jesodium/Blackout/arduino-mega/ref-images/L293D-Shield-Hardware-Overview.webp

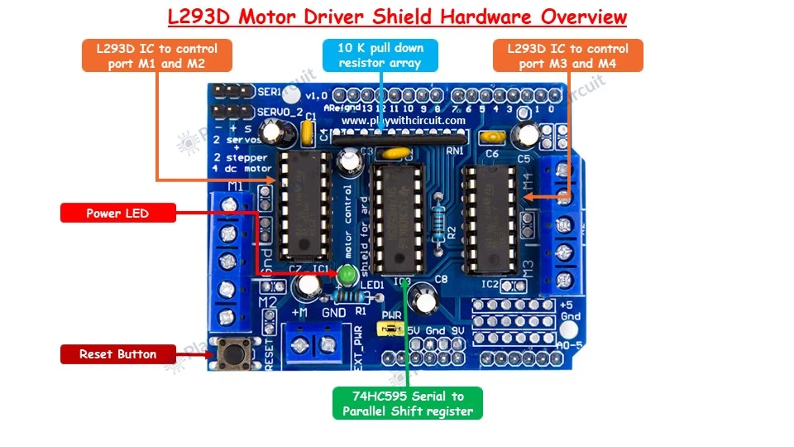
arduino-mega/ref-images/L293D-Shield-Hardware-Overview.webp
