jesodium/Blackout/docs/assets/frame-relic.jpg

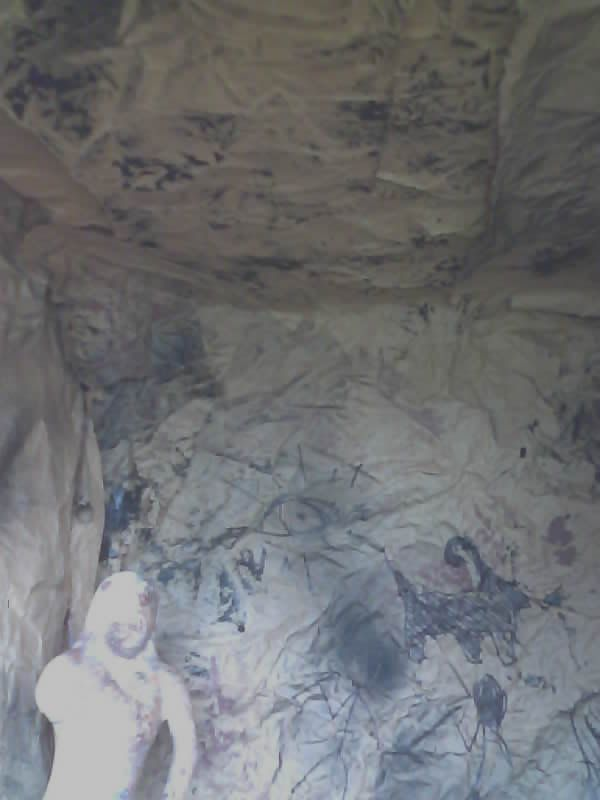
docs/assets/frame-relic.jpg
