jesodium/Blackout/arduino-mega-code/deepseek.md

See [AGENTS.md](AGENTS.md) for project context and wiring instructions.
