jesodium/Blackout/docs/assets/frame-debris.jpg

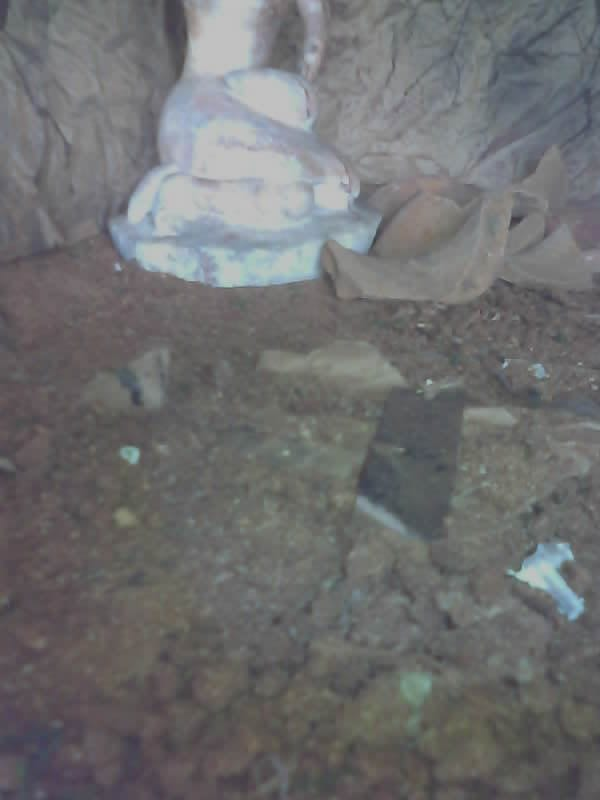
docs/assets/frame-debris.jpg
