jesodium/Blackout/docs/assets/frame-painted.jpg

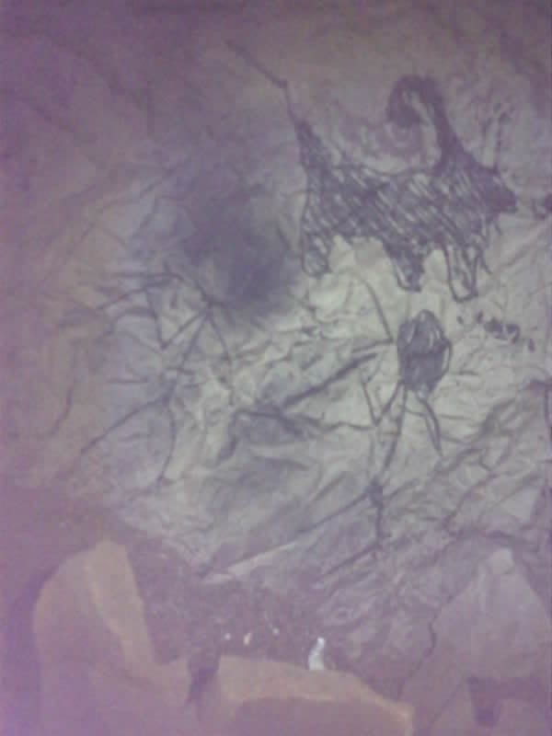
docs/assets/frame-painted.jpg
