jesodium/Blackout/docs/assets/frame-shapes.jpg

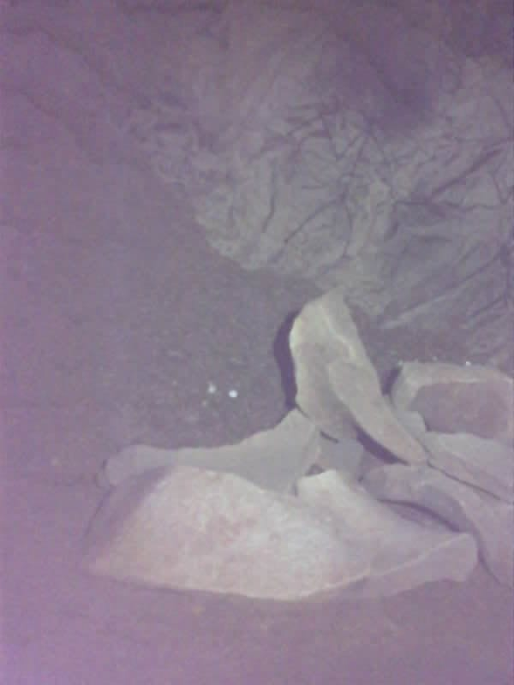
docs/assets/frame-shapes.jpg
