jesodium/Blackout/docs/assets/frame-void.jpg

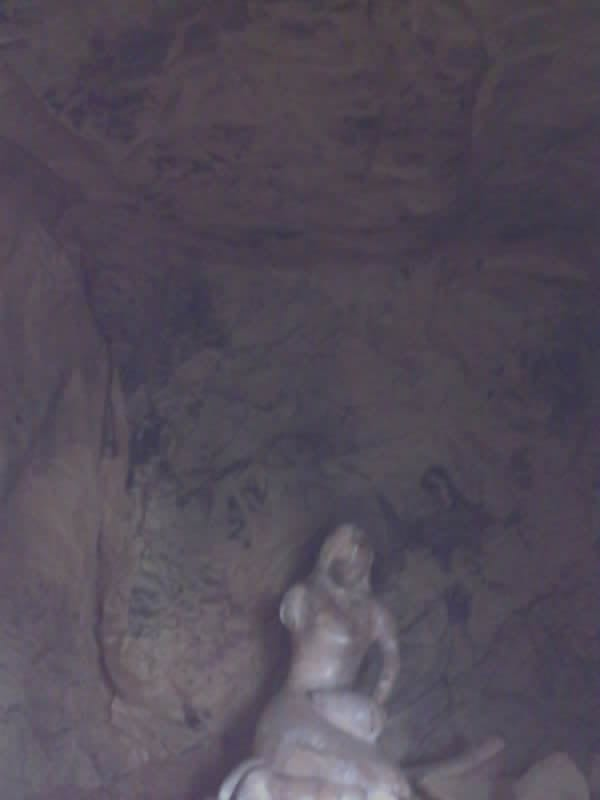
docs/assets/frame-void.jpg
