jesodium/Blackout/docs/assets/frame-water.jpg

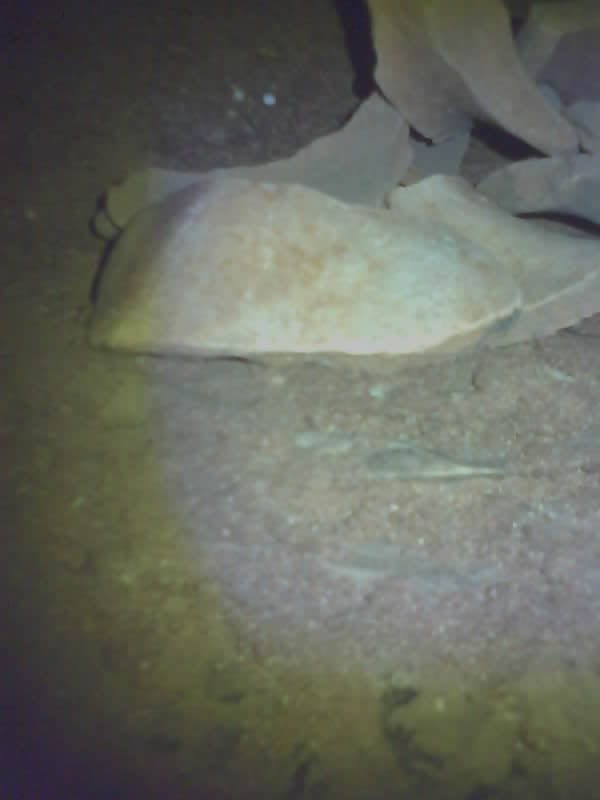
docs/assets/frame-water.jpg
