jesodium/Blackout/docs/assets/rover-cave.jpg

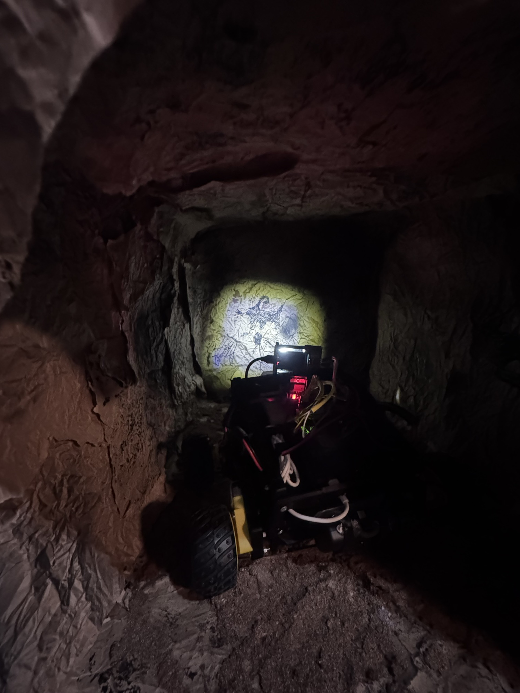
docs/assets/rover-cave.jpg
