jesodium/Blackout/docs/assets/rover.jpg

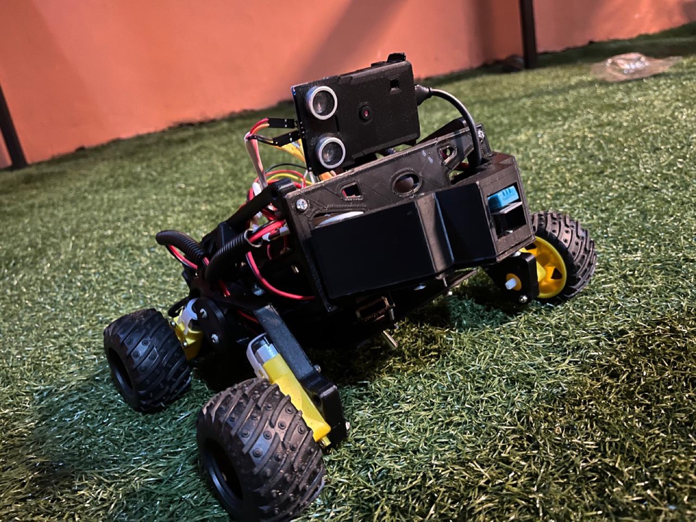
docs/assets/rover.jpg
