jesodium/Blackout/docs/assets/shot-blk-card.jpg

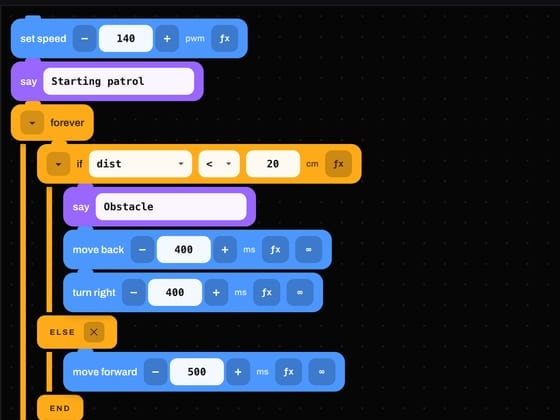
docs/assets/shot-blk-card.jpg
