jesodium/Blackout/docs/assets/shot-blk-sim.jpg

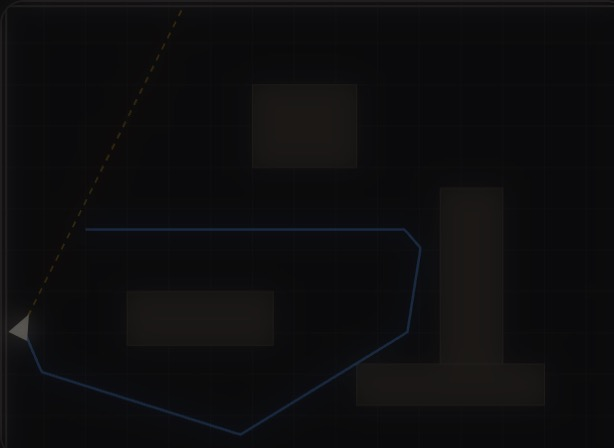
docs/assets/shot-blk-sim.jpg
