jesodium/Blackout/docs/assets/shot-fpv.jpg

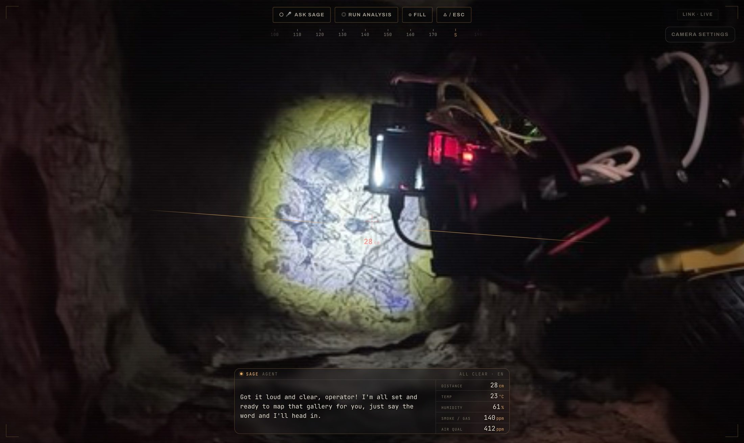
docs/assets/shot-fpv.jpg
