jesodium/Blackout/docs/assets/shot-report-card.jpg

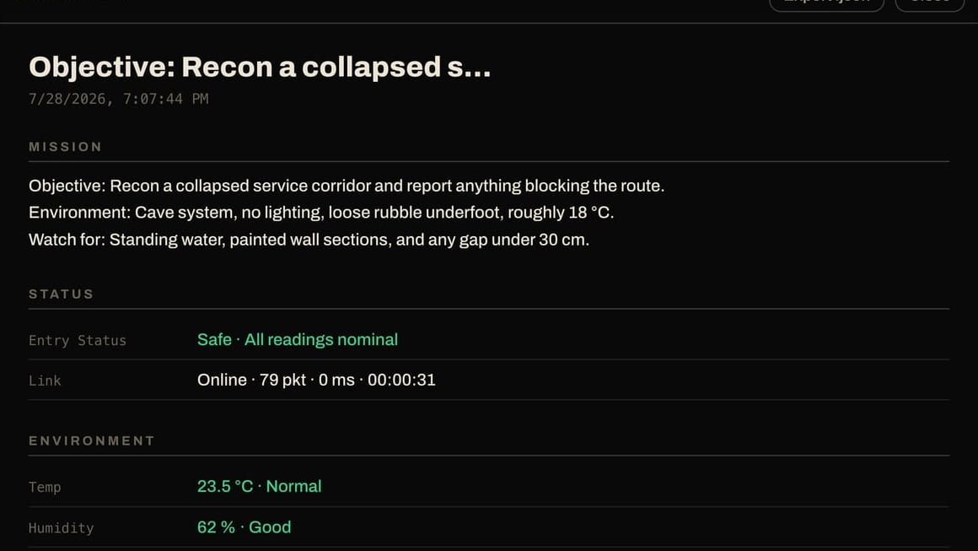
docs/assets/shot-report-card.jpg
