jesodium/Blackout/docs/assets/sponsor-steel-services.jpg

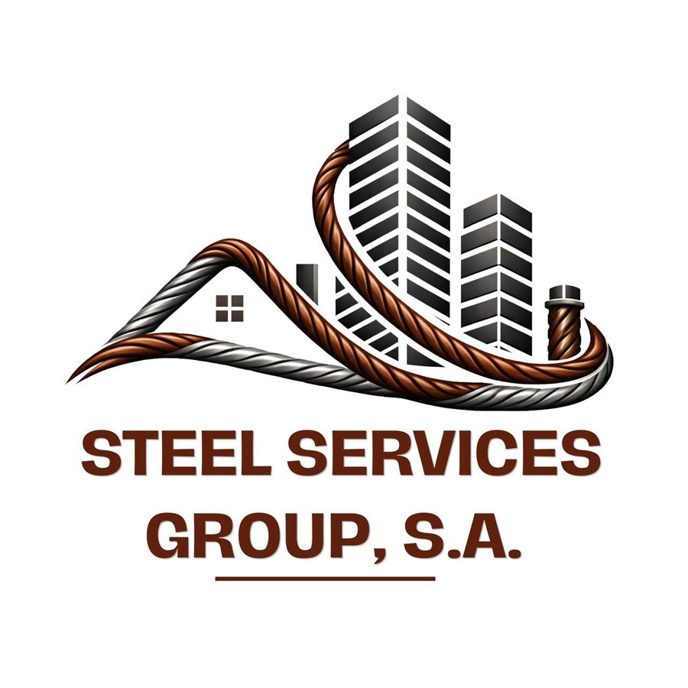
docs/assets/sponsor-steel-services.jpg
