jesodium/Blackout/docs/code-shots/0-repo-structure.png

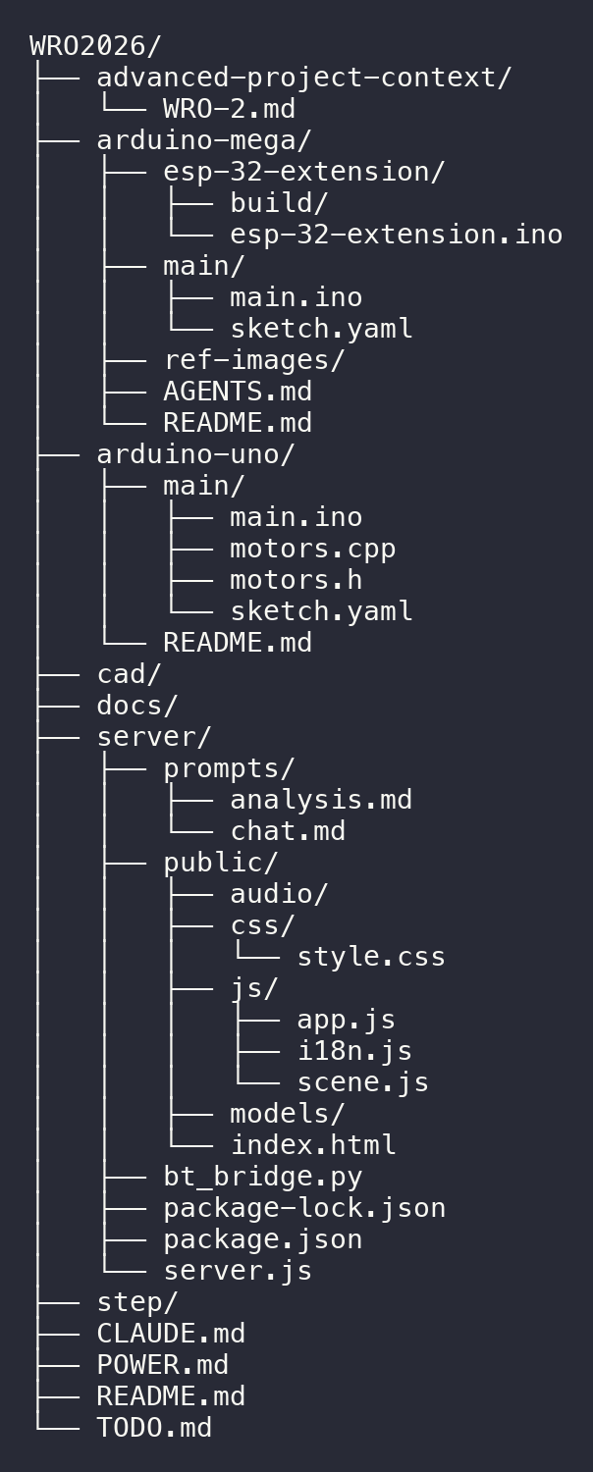
docs/code-shots/0-repo-structure.png
