jesodium/Blackout/docs/code-shots/1-mega-sensors.png

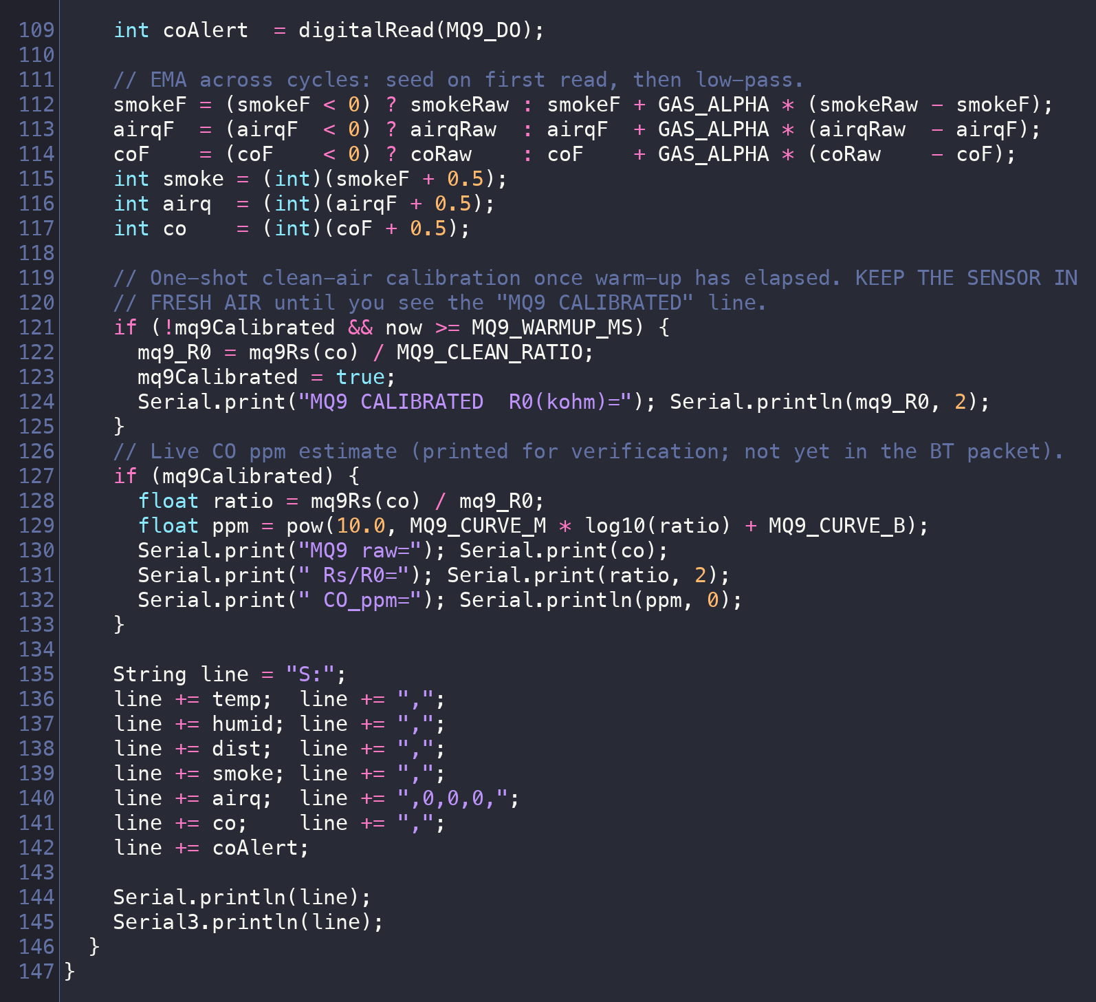
docs/code-shots/1-mega-sensors.png
