jesodium/Blackout/docs/code-shots/2-uno-motors.png

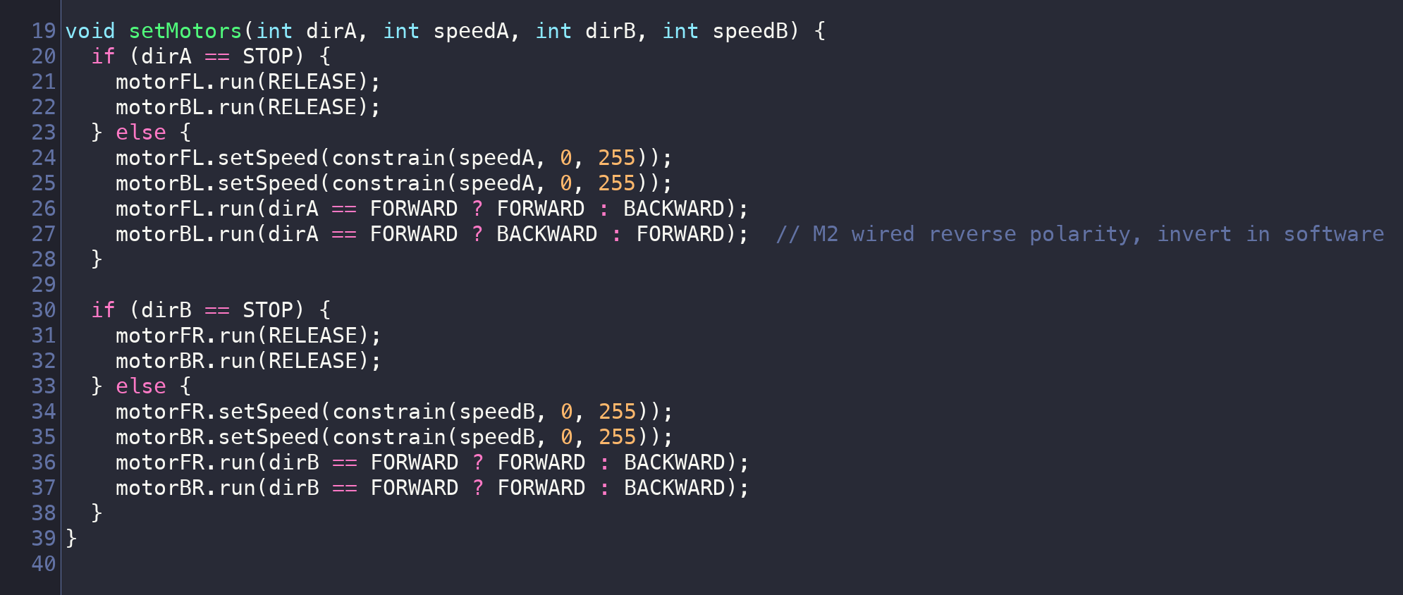
docs/code-shots/2-uno-motors.png
