jesodium/Blackout/docs/code-shots/3-server-telemetry.png

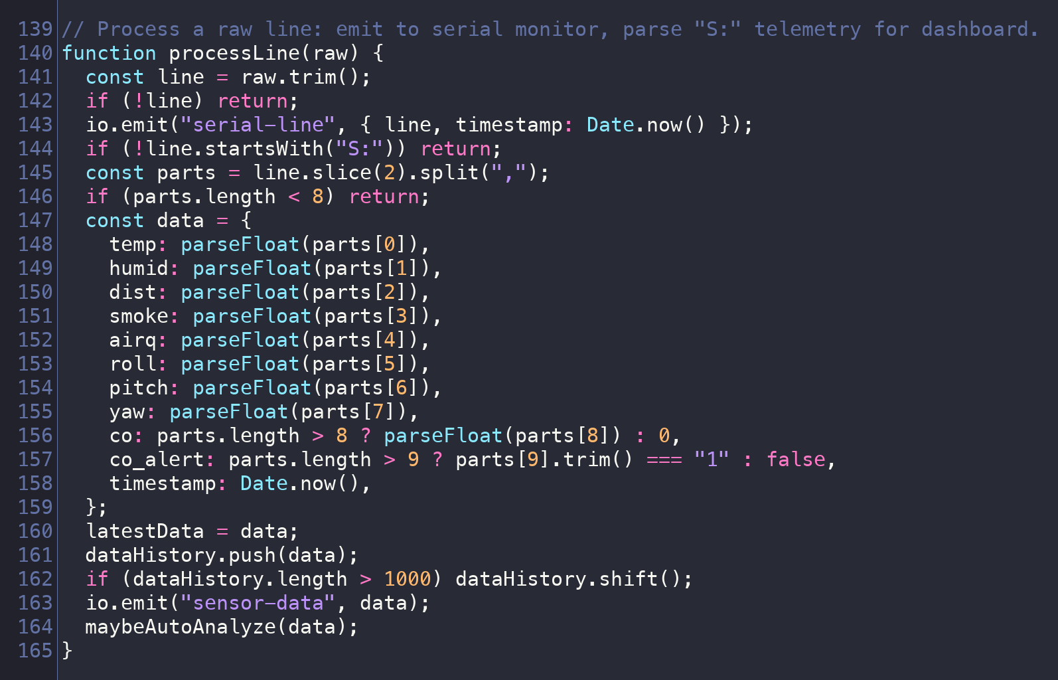
docs/code-shots/3-server-telemetry.png
