jesodium/Blackout/docs/code-shots/4-scene-threejs.png

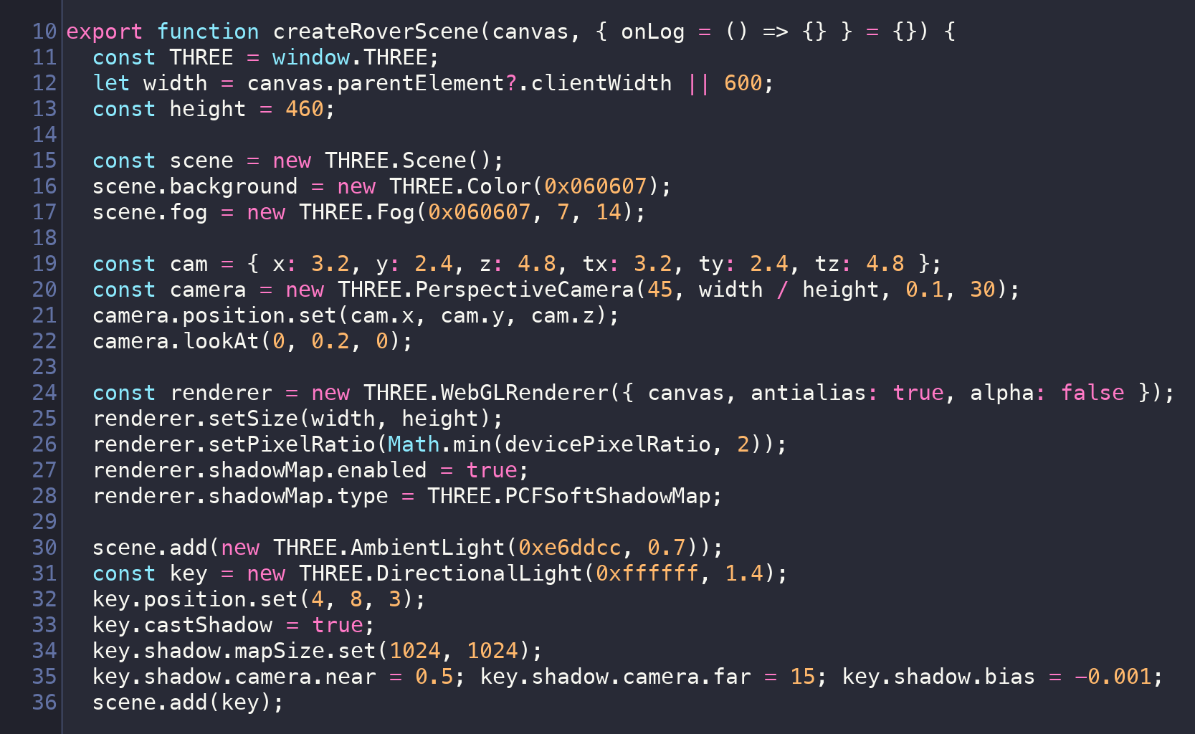
docs/code-shots/4-scene-threejs.png
