jesodium/Blackout/docs/figs/fig1.png

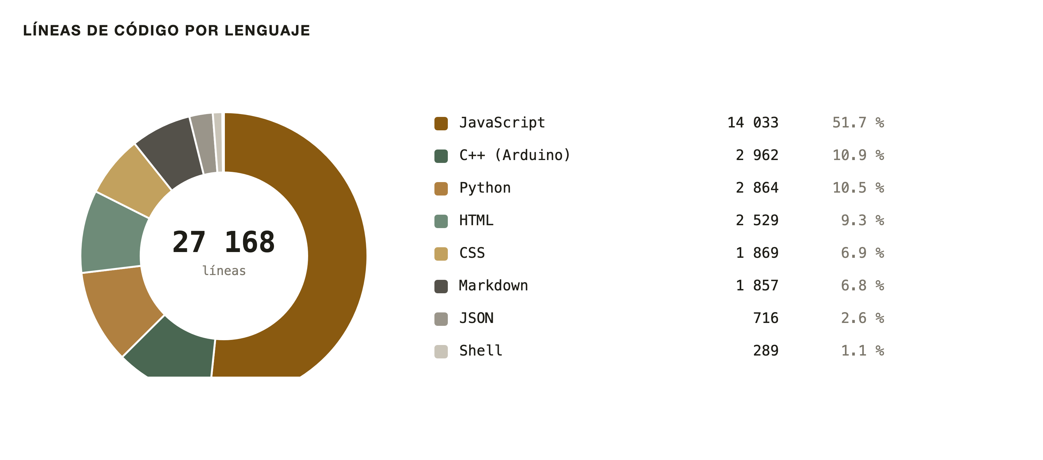
docs/figs/fig1.png
