jesodium/Blackout/docs/figs/fig3.png

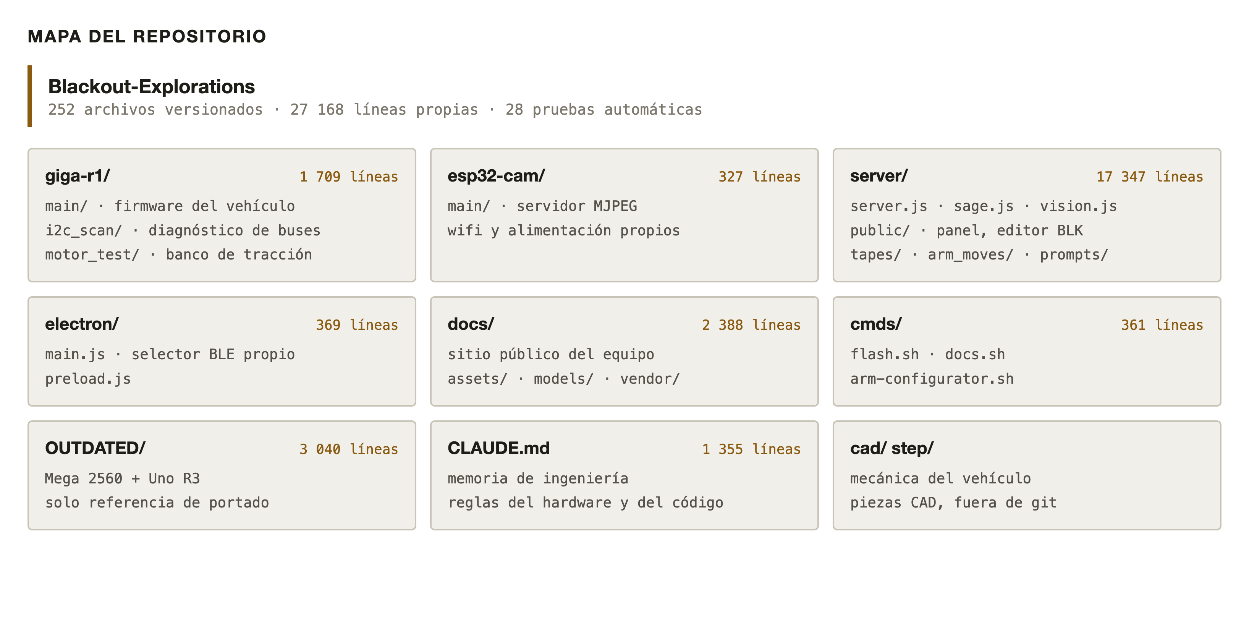
docs/figs/fig3.png
