jesodium/Blackout/stls/main_frame-MK2.STL

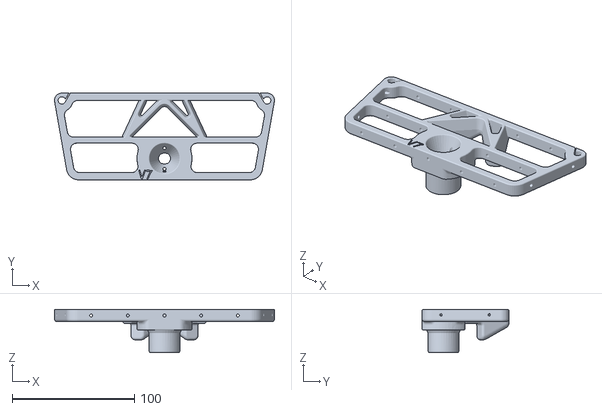
[picture p22: CAD file, 2026-05-28]
stls/main_frame-MK2.STL
180.0 x 71.0 x 35.4
