jesodium/Blackout/stls/rockers-MK2.STL

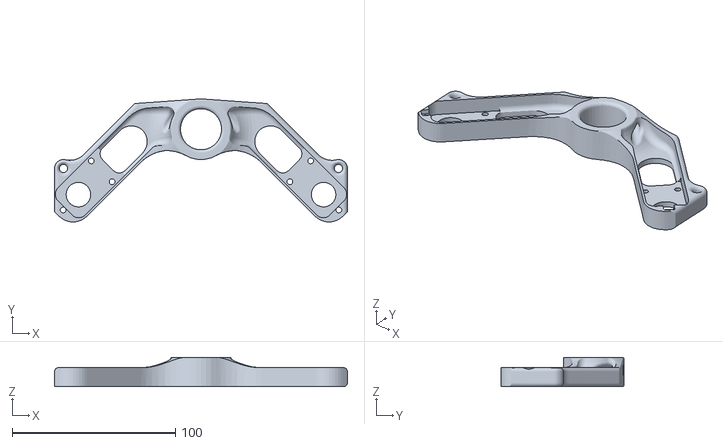
[picture p23: CAD file, 2026-05-28]
stls/rockers-MK2.STL
179.3 x 75.2 x 18.0
