jesodium/Blackout/stls/Brace_frame-MK2.STL

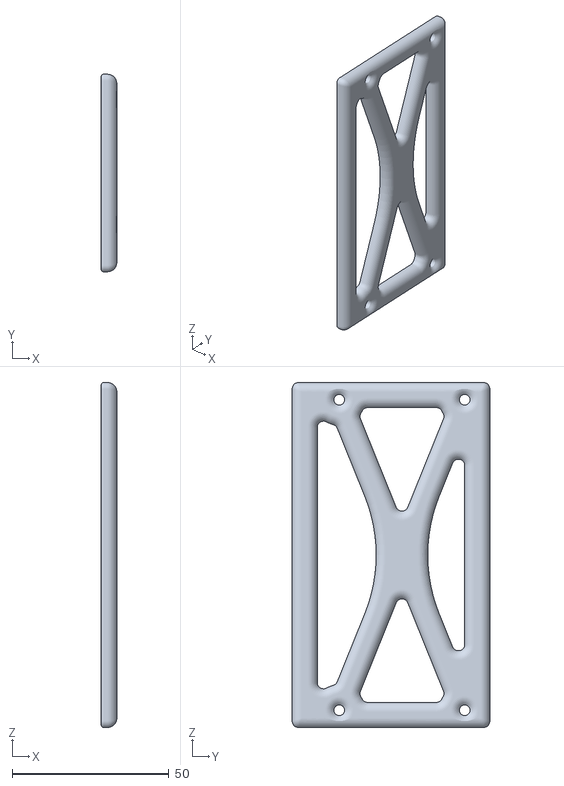
[picture p24: CAD file, 2026-05-28]
stls/Brace_frame-MK2.STL
5.00 x 63.0 x 110.0
