jesodium/Blackout/stls/belly_frame-MK2.STL

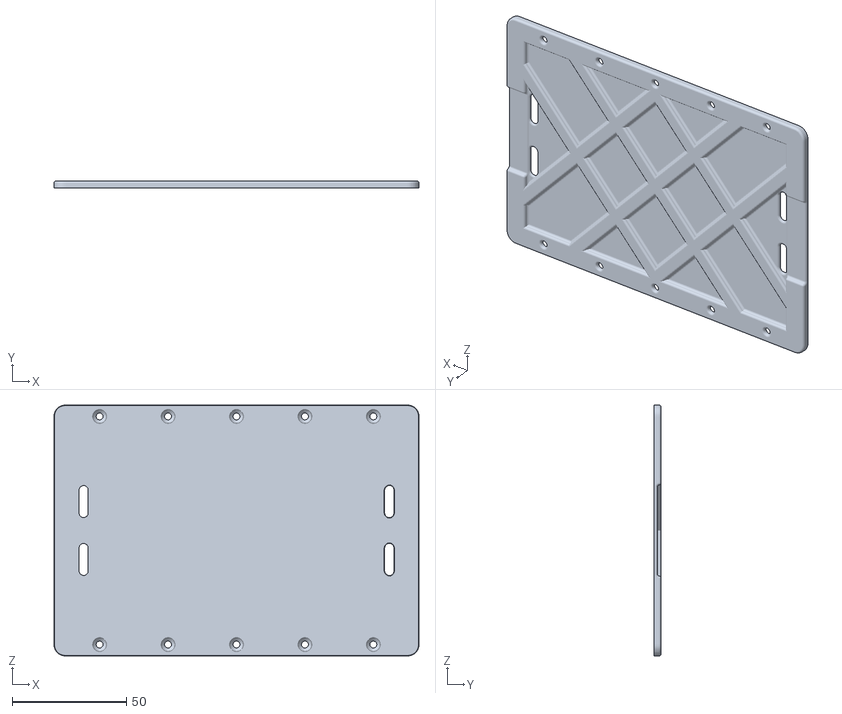
[picture p25: CAD file, 2026-05-28]
stls/belly_frame-MK2.STL
160.0 x 3.20 x 110.0
