jesodium/Blackout/stls/mid_frame-MK2.STL

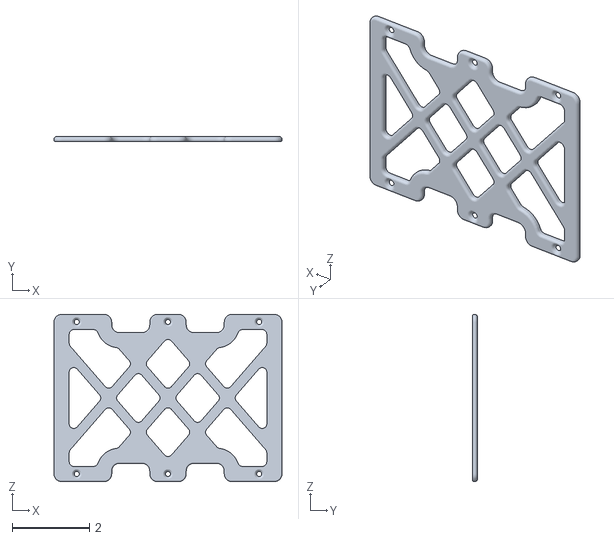
[picture p26: CAD file, 2026-05-28]
stls/mid_frame-MK2.STL
5.91 x 0.126 x 4.33
