jesodium/Blackout/stls/Pivot_cap-MK2.STL

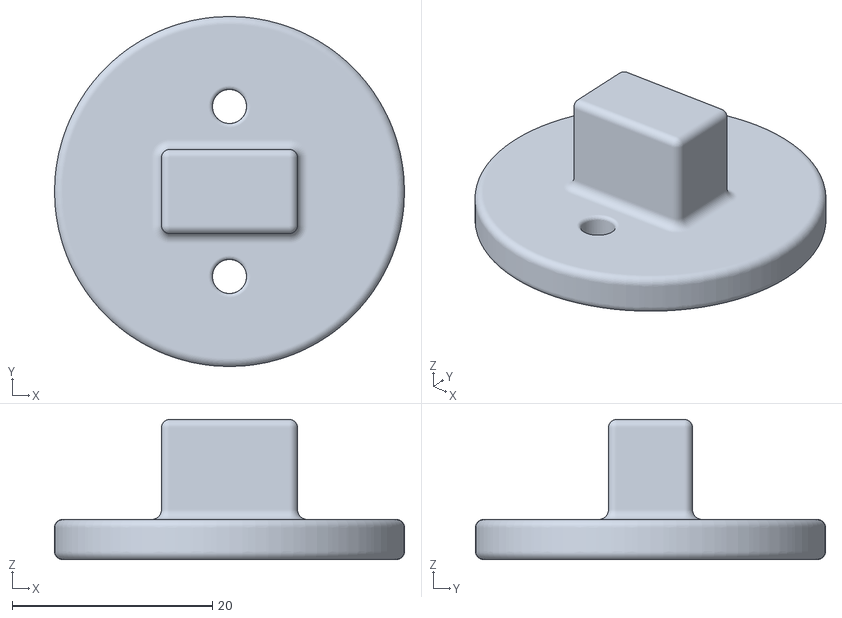
[picture p27: CAD file, 2026-05-28]
stls/Pivot_cap-MK2.STL
35.0 x 35.0 x 14.0
