jesodium/Blackout/stls/climber wheel-MK2.STL

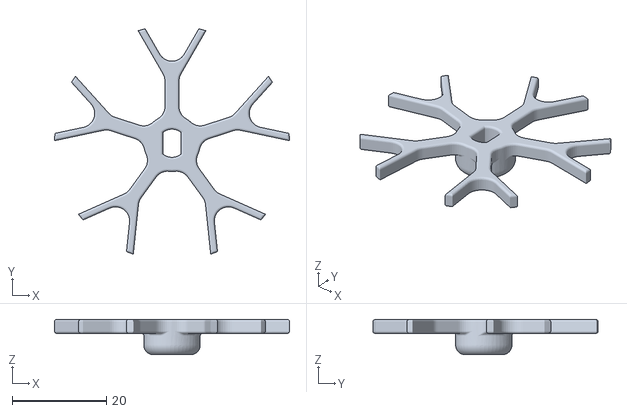
[picture p28: CAD file, 2026-05-28]
stls/climber wheel-MK2.STL
50.0 x 47.9 x 7.50
