jesodium/Blackout/step files [archives, backups]/Rover Model.STEP

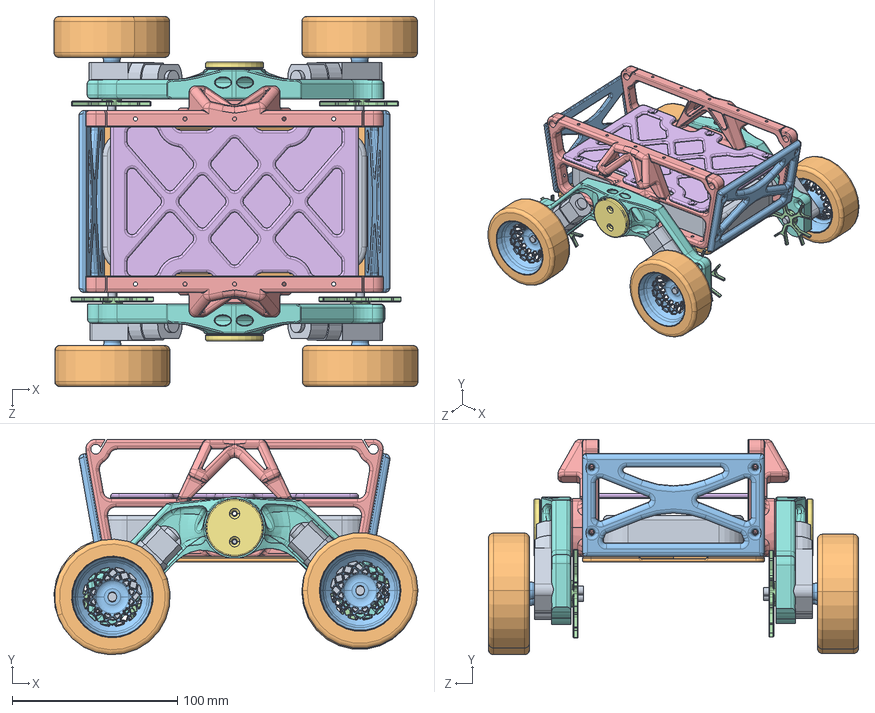
[picture p29: CAD file, 2026-05-28, an earlier design]
step files [archives, backups]/Rover Model.STEP
220.3 x 130.4 x 224.0 mm
BatteriePack
belly_frame-mk2
Brace_frame-mk2 x 2
climber wheel-mk2 x 4
main_frame-mk2 x 2
mid_frame-mk2
Pivot_cap-mk2 x 2
rockers-mk2 x 2
TTGearmotor-demo x 4
foam on wheel x 4
wheel_core-mk2 x 4
