jesodium/Blackout/(list of files, cad)

Other CAD files:
autodesk fusion [main files]/Rover Model.f3d
