jesodium/Blackout/arduino-uno-r4/main/main.ino

// uno r4 wifi — sensor hub + motion routines. reads sensors, broadcasts csv over
// ble notify. same "s:" format the server already parses (temp,humid,dist,
// smoke,airq,roll,pitch,yaw,co,co_alert,pressure,routine). everything from co
// onward is optional, so older lines without them still parse.
// also emits "e:analyze" lines: routine events for the dashboard, not
// telemetry. the server ignores anything that isn't "s:".
// order matters: arduinographics before arduino_led_matrix.
#include <ArduinoGraphics.h>
#include <Arduino_LED_Matrix.h>
#include <TextAnimation.h>
#include <ArduinoBLE.h>
#include <DHT11.h>
#include "routines.h" // op/step + the presentation and run tables

#define DHT_PIN 2   // dht11 data pin. d2 = clean digital; not d13 (onboard led
                    // shares that line and glitches the timing).
#define TRIG_PIN 11
#define ECHO_PIN 12
// l298n direction pins. d4-d7 = contiguous free block, no timer/peripheral
// conflict (d11/d12 sonar, d2 dht, d13 onboard led all clear). d9 is free —
// it drove the camera servo before the camera was fixed.
#define IN1 4  // motor a
#define IN2 5
#define IN3 6  // motor b
#define IN4 7
// enable pins = pwm speed control. d3/d10 are the free pwm-capable pins here.
// important note: pull the ena/enb jumpers off the l298n first — left on, they
// tie enable to 5v and these pins do nothing (motors stay full speed).
#define ENA 3  // motor a speed
#define ENB 10 // motor b speed
#define SONAR_ITER 3            // pings per reading, median drops spikes
#define SONAR_TIMEOUT_US 25000UL // ~430cm round-trip + margin, no echo = timeout
#define DIST_ALPHA 0.6 // ema smoothing on distance — ultrasonic is already clean
                        // (median-of-3 kills spikes), so light smoothing is enough.

#define DHT_INTERVAL 2000 // dht11 tops out ~1hz, read every 2s, cache between.
#define SEND_INTERVAL 100

BLEService sensorService("19b10000-e8f2-537e-4f6c-d104768a1214");
BLEStringCharacteristic sensorChar("19b10001-e8f2-537e-4f6c-d104768a1214", BLERead | BLENotify, 100);
// command channel: server (via the browser's web bluetooth) writes here to
// trigger actions. "go,<routine>" starts a motion routine, "stop" cuts motors.
BLEStringCharacteristic cmdChar("19b10002-e8f2-537e-4f6c-d104768a1214", BLEWrite, 20);

// the routine tables live in routines.h — edit that file to change what
// the robot does. everything here is the machinery that runs them: the board plays
// a routine standalone (the browser just writes "go,presentation"), so a ble
// dropout mid-run doesn't strand it. steps advance on a millis() stepper, never
// delay() — a blocking routine would freeze loop(), killing ble.poll() and the
// telemetry send for the whole run.
const Step* routine = nullptr; // null = idle
uint8_t stepIdx = 0;
unsigned long stepStart = 0;

ArduinoLEDMatrix matrix;
DHT11 dht(DHT_PIN);
int dhtTemp = 0, dhtHumid = 0; // last good dht11 read, cached between polls
// max frames ~= text length * font width (5px/char for font_5x7) — 80 covers
// "  blackout  " with headroom.
TEXT_ANIMATION_DEFINE(matrixAnim, 80)
volatile bool matrixReplay = false;

unsigned long lastSend = 0;
unsigned long lastDht = 0;
float distF = -1; // ema state, -1 = uninitialised

void setup() {
  Serial.begin(9600);
  Serial.setTimeout(50); // readstringuntil on a partial line must not block the
                         // default 1s — that stalls ble.poll + the routine stepper
  pinMode(TRIG_PIN, OUTPUT);
  pinMode(ECHO_PIN, INPUT);

  for (int p = IN1; p <= IN4; p++) { pinMode(p, OUTPUT); digitalWrite(p, LOW); }
  pinMode(ENA, OUTPUT); pinMode(ENB, OUTPUT);
  analogWrite(ENA, 0); analogWrite(ENB, 0); // stopped until told otherwise

  matrix.begin();
  matrix.beginDraw();
  matrix.stroke(0xFFFFFFFF);
  matrix.textFont(Font_5x7);
  matrix.textScrollSpeed(60);
  matrix.setCallback(matrixDone);
  matrix.beginText(0, 1, 0xFFFFFF);
  matrix.println("BLACKOUT ");
  matrix.endTextAnimation(SCROLL_LEFT, matrixAnim);
  matrix.loadTextAnimationSequence(matrixAnim);
  matrix.play();
  matrix.endDraw();

  if (!BLE.begin()) {
    while (1) { Serial.println("BLE init failed"); delay(1000); }
  }
  // known arduinoble/r4 wifi bug: the advertised name always shows as
  // "arduino" regardless of setlocalname() (the esp32-s3 co-processor doesn't
  // honor it in the ad packet, only in the post-connect gatt device-name
  // characteristic). so the browser filters by this service uuid instead.
  BLE.setLocalName("BLACKOUT-V1");
  BLE.setAdvertisedService(sensorService);
  sensorService.addCharacteristic(sensorChar);
  sensorService.addCharacteristic(cmdChar);
  BLE.addService(sensorService);
  BLE.advertise();
  Serial.println("BLE advertising as BLACKOUT-V1");
}

void matrixDone() { matrixReplay = true; } // irq context — keep it fast

// both motors forward at `speed` (0-255 pwm). if a motor spins backward, swap
// that motor's two output wires at the l298n screw terminals — don't flip the
// pin logic here or forward/back stop meaning the same thing.
void forward(uint8_t speed) {
  digitalWrite(IN1, LOW); digitalWrite(IN2, HIGH);
  digitalWrite(IN3, LOW); digitalWrite(IN4, HIGH);
  analogWrite(ENA, speed); analogWrite(ENB, speed);
}

void back(uint8_t speed) {
  digitalWrite(IN1, HIGH); digitalWrite(IN2, LOW);
  digitalWrite(IN3, HIGH); digitalWrite(IN4, LOW);
  analogWrite(ENA, speed); analogWrite(ENB, speed);
}

// pivot turns: motors oppose, robot spins about its own centre rather
// than arcing. turn *angle* is whatever `ms` buys you at this speed — open loop,
// no encoders, so it drifts with battery charge. tune on the field, not the bench.
void left(uint8_t speed) {
  digitalWrite(IN1, LOW); digitalWrite(IN2, HIGH);
  digitalWrite(IN3, HIGH); digitalWrite(IN4, LOW);
  analogWrite(ENA, speed); analogWrite(ENB, speed);
}

void right(uint8_t speed) {
  digitalWrite(IN1, HIGH); digitalWrite(IN2, LOW);
  digitalWrite(IN3, LOW); digitalWrite(IN4, HIGH);
  analogWrite(ENA, speed); analogWrite(ENB, speed);
}

void halt() {
  analogWrite(ENA, 0); analogWrite(ENB, 0);
  digitalWrite(IN1, LOW); digitalWrite(IN2, LOW);
  digitalWrite(IN3, LOW); digitalWrite(IN4, LOW);
}

void applyStep(const Step& s) {
  switch (s.op) {
    case FWD:   forward(s.pwm); break;
    case BACK:  back(s.pwm);    break;
    case LEFT:  left(s.pwm);    break;
    case RIGHT: right(s.pwm);   break;
    case ANALYZE:
      halt(); // stand still — camera needs a clean frame, not a blurry one
      // fire-and-forget on the notify channel the browser already listens to. if
      // notify drops we miss one analysis, routine keeps going.
      sensorChar.writeValue("E:analyze");
      Serial.println("E:analyze");
      break;
    default:    halt();         break; // wait + end both mean wheels still
  }
}

// direct drive for the dashboard's motor-debug panel: "drv,<fwd|back|left|right>,<pwm>[,<ms>]".
// always time-limited (default 800ms, cap 10s) so a dropped link or missed stop
// never leaves the wheels spinning. overrides any running routine.
unsigned long drvEnd = 0;

void stopRoutine() { routine = nullptr; drvEnd = 0; halt(); }

void startDrive(const String& c) {   // c = "drv,verb,pwm[,ms]"
  int a = c.indexOf(',', 4);
  if (a < 0) return;
  String verb = c.substring(4, a);
  int b = c.indexOf(',', a + 1);
  int pwm = constrain((b < 0 ? c.substring(a + 1) : c.substring(a + 1, b)).toInt(), 0, 255);
  long ms = b < 0 ? 800 : constrain(c.substring(b + 1).toInt(), 50, 10000);
  routine = nullptr;
  if      (verb == "fwd")   forward(pwm);
  else if (verb == "back")  back(pwm);
  else if (verb == "left")  left(pwm);
  else if (verb == "right") right(pwm);
  else { halt(); return; } // unknown verb, wheels stay still
  drvEnd = millis() + ms;
  Serial.print("drv: "); Serial.println(c);
}

// auto-halt an expired debug drive. called every loop(), non-blocking.
void tickDrive() {
  if (drvEnd && millis() >= drvEnd) { drvEnd = 0; halt(); }
}

void startRoutine(const String& name) {
  if (name == "presentation") routine = PRESENTATION;
  else if (name == "run") routine = RUN;
  else if (name == "test") routine = TEST;
  else if (name == "mission") routine = MISSION;
  else if (name == "test2") routine = TEST2;
  else return; // unknown name, stay idle rather than guess
  drvEnd = 0;  // kill any pending debug-drive auto-halt or it fires mid-step
  stepIdx = 0;
  stepStart = millis();
  applyStep(routine[0]);
  Serial.print("routine start: "); Serial.println(name);
}

// advance the active routine if the current step has run out its time. called
// every loop() — must stay non-blocking.
void tickRoutine() {
  if (!routine) return;
  if (routine[stepIdx].op == END) { stopRoutine(); Serial.println("routine done"); return; }
  if (millis() - stepStart < routine[stepIdx].ms) return;
  stepIdx++;
  stepStart = millis();
  applyStep(routine[stepIdx]);
}

// one parser for both transports: ble cmdchar and usb serial. serial parity means
// routines are testable at the bench with no ble, no browser, no pairing.
void handleCmd(String c) {
  c.trim();
  if (c == "stop") stopRoutine();
  else if (c.startsWith("go,")) startRoutine(c.substring(3));
  else if (c.startsWith("drv,")) startDrive(c);
  // unknown verb, ignore. the board only moves when explicitly told to.
}

// one hc-sr04 ping in cm via plain pulsein() — portable across cores, unlike
// newping's avr-cycle-counted timing (wrong on this board's clock speed).
// returns -1 on timeout (no echo / out of range).
float pingCm() {
  digitalWrite(TRIG_PIN, LOW);
  delayMicroseconds(2);
  digitalWrite(TRIG_PIN, HIGH);
  delayMicroseconds(10);
  digitalWrite(TRIG_PIN, LOW);
  unsigned long us = pulseIn(ECHO_PIN, HIGH, SONAR_TIMEOUT_US);
  return us > 0 ? us / 58.0 : -1;
}

// median of sonar_iter pings drops spikes, same intent as the old newping call.
float medianPingCm() {
  float s[SONAR_ITER];
  uint8_t n = 0;
  for (uint8_t i = 0; i < SONAR_ITER; i++) {
    float v = pingCm();
    if (v >= 0) s[n++] = v;
    delay(60); // hc-sr04 needs >=60ms between pings or the transducer ring-down
               // from the prior burst latches a false ~20cm echo (datasheet spec)
  }
  if (n == 0) return -1;
  for (uint8_t i = 1; i < n; i++) { // insertion sort, n is tiny
    float key = s[i];
    int j = i - 1;
    while (j >= 0 && s[j] > key) { s[j + 1] = s[j]; j--; }
    s[j + 1] = key;
  }
  return s[n / 2];
}

void loop() {
  BLE.poll();

  if (cmdChar.written()) handleCmd(cmdChar.value());
  if (Serial.available()) handleCmd(Serial.readStringUntil('\n'));

  tickRoutine(); // before the send_interval return below — that skips the rest
                 // of loop() most iterations, which would stall the routine.
  tickDrive();

  if (matrixReplay) { // loop the scroll forever
    matrixReplay = false;
    matrix.beginText(0, 1, 0xFFFFFF);
    matrix.println("BLACKOUT ");
    matrix.endTextAnimation(SCROLL_LEFT, matrixAnim);
    matrix.loadTextAnimationSequence(matrixAnim);
    matrix.play();
  }

  unsigned long now = millis();
  if (now - lastSend < SEND_INTERVAL) return;
  lastSend = now;

  // median-of-3 blocks ~180-250ms (60ms forced between pings), which would cap
  // the routine stepper's resolution — a 400ms turn could overshoot 60%.
  // during a routine take a single ~25ms ping instead: noisier distance, but steps
  // land on time and telemetry keeps flowing. consecutive pings still land
  // send_interval (100ms) apart, clear of the 60ms ring-down.
  float raw = routine ? pingCm() : medianPingCm();
  if (raw >= 0) {
    distF = (distF < 0) ? raw : distF + DIST_ALPHA * (raw - distF);
  } else {
    distF = -1; // miss = out of range, don't hold a stale value
  }
  // miss = no echo within ~430cm = clear ahead. send 999, never 0 — 0 reads as
  // "touching a wall" downstream (dashboard "too close", server "near" blurt).
  float dist = (distF < 0) ? 999 : distF;

  // dht11 caps at ~1hz — poll on its own slow cadence, hold last good value.
  if (now - lastDht >= DHT_INTERVAL) {
    lastDht = now;
    int t, h;
    if (dht.readTemperatureHumidity(t, h) == 0) { dhtTemp = t; dhtHumid = h; }
  }

  // important note: only dht11 + hc-sr04 exist now — no gas/pressure sensor.
  // smoke/airq/co/co_alert/pressure fields stay 0 until a real one lands.
  String line = "S:";
  line += dhtTemp;
  line += ",";
  line += dhtHumid;
  line += ",";
  line += dist;
  line += ",0,0,0,0,0,0,0,0";
  // field 11: routine running? the server gates auto-analysis on this. sent on
  // every line rather than as a start/end event — a dropped event
  // would strand the server thinking a routine runs forever, a flag self-heals.
  line += routine ? ",1" : ",0";

  Serial.println(line);
  sensorChar.writeValue(line);
}
