jesodium/Blackout/(commit log)

2026-05-28 Add new STL file for MK2 rockers
2026-05-28 Initialize Arduino Mega project with main code, README, AGENTS, and configuration files
2026-05-30 Remove obsolete STL files for MK2 components including Brace_frame, Pivot_cap, belly_frame, climber wheel, main_frame, mid_frame, and rockers.
2026-05-30 Add telemetry dashboard with real-time sensor data visualization
    - Implemented socket connection for real-time data updates.
    - Created a typewriter effect for displaying AI analysis.
    - Developed a telemetry plotter for visualizing sensor data over time.
    - Added sparkline graphs for individual sensor readings.
    - Implemented a logging system with filters for different log types.
    - Created a 3D scene using Three.js to visualize the rover model and its telemetry data.
    - Added a rover model in GLB format for 3D visualization.
2026-06-10 style: restyle dashboard — square UI, warm palette, clean header
    - All border-radius flattened to 2px (panels, buttons, pills, tags, toggles)
    - Color palette swapped to 222831/393e46/948979/dfd0b8
    - Removed radial gradient background, flat color
    - Header: drop icon and subtitle, show BLACKOUT in mono bold
    - Also: persist TTS toggle in localStorage, fix serial port switch listener leak
2026-06-10 feat: add free-orbit drag camera to orientation viewer
    Click "free" to grab and drag the 3D viewport — orbits around the
    rover in spherical coords. Switching to any preset exits free mode.
2026-06-10 feat: add MQ-9 sensor support for CO detection and update data handling
2026-06-11 feat: serial monitor + ultrasonic pin remap + full pinout docs
    - server: stream every raw serial line via new `serial-line` event;
    dedupe the two parser blocks into a shared attachParser()
    - dashboard: collapsible Serial Monitor panel (Hide/Pause/Clear,
    backtick toggle, persisted state)
    - mega: remap HC-SR04 to TRIG A6 / ECHO A5
    - docs: document every Mega pin — add HC-06 STATE (D27), EN (D28),
    and USB serial (D0/D1) to AGENTS.md pinout + wiring tables
2026-06-11 style: make sensor gauges horizontal thin bars
    Reading shown as text above a slim 6px horizontal track that fills
    left→right; drops the tall 280px vertical column layout.
2026-06-17 Refactor UI components and improve styling; update font and color scheme
    - Updated font links in index.html to use Anton and Archivo for improved readability.
    - Refactored app.js to enhance UI structure, including new Head component for section headers.
    - Improved styling for trends, readings, and logs panels for better visual hierarchy.
    - Adjusted color scheme for better contrast and aesthetics in graphs and UI elements.
    - Added new Ticker component for real-time data display.
    - Introduced power management documentation in POWER.md for clearer wiring instructions.
    - Created HC-05 AT-command passthrough sketch for easier Bluetooth module configuration.
2026-06-18 feat: integrate Microsoft Edge TTS for voice synthesis and enhance agent UI
    - Added msedge-tts package for TTS functionality via server proxy.
    - Implemented TTS endpoint to stream audio responses from Microsoft Edge neural voices.
    - Updated agent UI to reflect mood and intent based on sensor data and AI analysis.
    - Enhanced CSS for agent animations and speech display.
    - Refactored speech synthesis logic to include fallback to browser TTS.
    - Improved AI analysis prompt and response handling for better operator communication.
    - Added mock data functionality for testing without hardware.
2026-06-21 remove HC-06 code, clean firmware, prep for ESP32 serial relay
2026-06-21 switch to ESP32-CAM Bluetooth SPP relay, update power/docs
2026-06-21 feat: friendlier agent reactions, casual obstacle framing, gas throttle
    - Add text-emoticon faces per agent mood (o_o, x_x, ^_^, etc.)
    - Humidity: split "Out of range" into "Highly humid" / "Too dry"
    - Throttle smoke + air-quality display to 5s (noisy MQ sensors)
    - Distance reframed as navigation: <10cm red, else steer-around (no evacuate)
    - Prompts: close wall is navigation, reserve back-out talk for real hazards
    Claude-Session: https://claude.ai/code/session_01E4kevoaFLgZisXAfABEFAN
2026-06-21 feat: agent sessions, mission onboarding wizard, edge-triggered analysis
    - Chat sessions UI: select/create/delete briefed recon sessions
    - Multi-step mission briefing wizard with mic dictation + summary review
    - Edge-triggered AI analysis (fires on status change, not interval) + instant canned reactions
    - Mission + trend context injected into analysis/chat prompts
    - Server-side status tags single source of truth; ignore twitchy MQ9 DO flag, judge CO from raw
    - Distance: caution only <10cm; median + EMA smoothing on HC-SR04 (Mega)
    - Deepgram TTS retries before Edge fallback
    - Anti prompt-injection guard in chat persona
    - Remove auto-analysis cron (on-demand only)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
2026-06-22 feat: sentence-streamed TTS, Analysis findings panel, layout + voice toggle
    - TTS plays first sentence immediately + prefetches next (gapless, faster start)
    - Analysis panel: per-session mission findings logged on metric threshold crossings
    - Stack Environment under Orientation; Analysis takes the third stage slot
    - Voice toggle moved to always-visible top bar (works during onboarding)
    - Blackout speaks intro greeting on New Chat
    - Gate auto-analysis/blurts to active briefed session (no boot chatter), server too
    - Animation polish across session picker, onboarding wizard, full agent view
    Claude-Session: https://claude.ai/code/session_0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
2026-06-22 refactor: remove ESP32-CAM Bluetooth code and configuration files
2026-06-22 feat: switch BT relay to ESP32-WROOM on Serial2, drop ESP32-CAM
    Mega link moves to GPIO16 (Serial2 @ 9600), freeing USB UART0 for debug.
    Byte-level relay both ways. Remove CAM relay sketch; update wiring docs.
    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
2026-06-23 feat: i18n, BT bridge, agent language switching, pre-rendered onboarding audio
2026-06-25 feat: migrate Uno to L298N, bridge data-flow check, stale sensor UI
    - arduino-uno: drop dead L293D shield (couldn't reverse), rewrite for
    L298N dual H-bridge with per-side INV flags; remove motors.cpp/.h
    - esp32: correct RX pin to GPIO19
    - server: bridge/start now waits up to 8s for ESP32 data, fails honestly
    if none arrives; add stale/unavailable sensor styling + i18n strings
    Claude-Session: https://claude.ai/code/session_01URcr372sdfbiJmsu3yuBv4
2026-07-07 chore: retire two-board setup, add Uno R4 WiFi build
    Move Mega 2560 + Uno R3 sketches to OUTDATED/, add arduino-uno-r4/
    as the active single-board build. Update docs, dashboard, and server
    for the new BLE data flow.
    Claude-Session: https://claude.ai/code/session_013gJRQ6vC523sXUNgsHDsdf
2026-07-07 feat: servo camera-pan test button over BLE
    Browser grabs the R4's cmd characteristic (19b10002) on connect and a
    ⟲cam button writes to it to trigger a servo sweep for aiming the camera.
    Split diagnostics distinguish no-link vs old-firmware. EN/ES strings.
    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
2026-07-08 feat: sonar miss clears stale distance, retire root POWER.md
    - pingCm debug trace over serial while wiring is confirmed
    - distF resets to -1 on ping miss instead of holding last value
    - POWER.md moved under OUTDATED/ with the retired two-board notes
    Claude-Session: https://claude.ai/code/session_01W1zDKDsjvGSHFQEnHNmzn7
2026-07-09 fix: HC-SR04 needs >=60ms between pings to avoid false ~20cm echo
    Ring-down from the prior burst latched a stale near-distance reading;
    bumped inter-ping delay from 10ms to 60ms per datasheet.
    Claude-Session: https://claude.ai/code/session_01CWAhzUemjNti8J46NCwauA
2026-07-09 feat: ESP32-CAM MJPEG feed in dashboard, stop serial port-stealing
    Add standalone esp32-cam sketch (AI-Thinker MJPEG streamer) and a Camera
    zone that pulls http://blackout-cam.local/stream. Server no longer auto-grabs
    the first usbserial at boot (was stealing the cam's FTDI); gate behind
    SERIAL_AUTOCONNECT. Centralize serial auto-reconnect so a stale timer can't
    revive USB after switching to BT.
    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
2026-07-09 feat: bump ESP32-CAM to SVGA@q10, show full camera frame (contain)
    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
2026-07-10 feat: Sage speaks JSON + camera "look around" scan action
    Sage (Cerebras/gemma) now returns { text, status, action } instead of a
    bare string. Only text is voiced/shown; status tints the speech bubble;
    action:"sweep" lets Sage decide to look around.
    - server/sage.js: tolerant parseSage (raw-string fallback so a malformed
    turn still talks); askSage helper wraps all three LLM call sites.
    - POST /api/scan: grabs stills across a slow pan and lets Sage narrate.
    - vision.js: grabFrames(count,gapMs) for multi-angle capture.
    - Uno R4 firmware: "scan" cmd -> slow ~4s sweep; "sweep"/manual unchanged.
    - app.js: object-aware replies, runScan (drives the slow BLE pan + /api/scan),
    status accent, and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
2026-07-13 feat: wire BME280 for temp/humidity, drop DHT11 placeholder
    CSV protocol unchanged (temp,humid already in slot 0/1), so server
    and dashboard need no changes — they were just fed zeros before.
2026-07-13 feat: add BME280 pressure to telemetry, wire through server + dashboard ticker
2026-07-13 fix: infinite analysis spinner + clear no-camera message
    The ai-analysis socket listener only handled the success case, so any
    server-side error (bad key, cam down, Cerebras failure) left the
    dashboard stuck on "thinking" forever. Now it always clears analyzing.
    Also short-circuit runAiAnalysis with "I don't detect any camera"
    instead of silently running blind when eyeParts can't grab a frame.
2026-07-13 fix: analysis stays sensor-based when cam is down, just notes it can't see
    Previous fix short-circuited the whole analysis to a canned "no
    camera" line. Instead tell Sage in-prompt there's no feed so she
    mentions it in-character, then still reports off live telemetry.
2026-07-14 feat: swap BME280/MQ-9 for DHT11, add L298N drive, fix cam orientation
    - Uno R4: DHT11 on D2 replaces BME280+MQ-9; unwired CSV fields send 0
    - Uno R4: L298N motors on D4-D7 dir + D3/D10 PWM enable
    - ESP32-CAM: vflip+hmirror for upside-down module, DHCP for school net
    - Dashboard: editable cam host (mDNS name or raw IP), persisted, stream on :81
    Claude-Session: https://claude.ai/code/session_0172qi5PGwfUw2CLynvRfB4M
2026-07-15 feat: on-board motion routines, motor debug panel, single-still analyze
    - Uno R4: routines.h step tables (FWD/BACK/LEFT/RIGHT/WAIT/ANALYZE/END),
    millis() stepper in main.ino, "go,<routine>"/"stop"/"drv" BLE cmds,
    routine flag + E:analyze events on telemetry; servo dropped (cam fixed)
    - server: sweep -> analyze (camera no longer pans, 1 still), routine flag
    suppresses auto-analysis mid-run, sharp dep for vision resize
    - dashboard: MOTOR DEBUG bench panel (timed bursts, auto-halt), i18n/css
    - esp32-cam: orientation/secrets example tweaks, motor_test sketch
    Claude-Session: https://claude.ai/code/session_01F186BGkAgznqipMj5v5suP
2026-07-15 feat: gamepad manual control, chat sequence triggers, quieter no-cam fallback
    - Xbox/DualSense manual drive panel (autopilot toggle, dpad+stick, timed
    BLE bursts that auto-halt) with bilingual autopilot on/off callouts.
    - Chat phrases ("present yourself"/"preséntate", "time to explore"/"hora de
    explorar") fire the matching on-board routine directly over BLE instead of
    round-tripping the LLM.
    - Sage no longer calls out a dead camera — falls back to reporting from
    sensor readings alone, silently.
    - Tune SPEED_SLOW 120->125; document dictated-routine conventions in CLAUDE.md.
    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
2026-07-15 FIX IT SO THAT EVERYTIME THAT SAGE DOES A ANALYSIS THE CAMERA DISCONNECTS
    Claude-Session: https://claude.ai/code/session_01GoHymEjAsPZmu8uET8SB6d
2026-07-15 fix: auto-retry camera on drop, add missing Arduino CI libs
    Camera effect was pinging live streams every 60s instead of retrying
    dropped ones. CI compile was failing on every push since sketch.ino
    pulls ArduinoGraphics + DHT11, neither installed by the workflow.
    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
2026-07-15 feat: cam LED control, bump build to V2
    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
2026-07-16 feat: Sage headlamp control + findings log
    - sage.js: parse led (0-255, clamped) and finding from the JSON reply
    - server.js: drive cam lamp on led, save the still Sage saw to
    public/findings/ and emit sage-finding (5min dupe guard)
    - vision.js: setLed/getLed over the cam's /control, level remembered
    so the prompt can tell Sage where the lamp already is
    - prompts: headlamp + discovery rules (relic fragments, drawings)
    - app.js/style.css: findings render with their still in the Analysis panel
    - main.ino: lru_purge_enable + 2s send/recv timeouts, and the client
    hangs up explicitly on yield — suspects for the wedged stream after
    an analysis (unconfirmed on hardware)
2026-07-16 feat: MISSION routine + presentation greeting mode
    - routines.h: MISSION step table (nudge/settle/analyze), PRESENTATION
    reworked to a 4-pivot audience scan with one closing ANALYZE
    - app.js: analyze() takes a mode + guards re-entry, gamepad square fires
    analyze, "start the mission" chat trigger, ▶mission button
    - server.js: request-analysis carries mode; "present" swaps in
    prompts/present.md, a judge-greeting prompt instead of a cave read
    - maybeAutoAnalyze: blurts now silenced during routines too
2026-07-16 feat: TEST2 routine for 125ms vs 215ms burst A/B
    MISSION bursts now 125ms; TEST2 is the same sequence at 215ms so the two
    can be compared on the field. TEST2 is button-only (no Sage trigger
    phrase) — fold the winning number back into MISSION and delete it.
    Claude-Session: https://claude.ai/code/session_01Gsh2NdLzTaaksSQotXrZf7
2026-07-19 untrack workflows/ — operator-saved .blk files stay local
2026-07-19 animate popup close — editor + sage exit before unmount/hide
2026-07-19 rebrand V2→V3, accent red→blue, split cam/3d boxes side-by-side, custom form styling, fix mode-seg grid
2026-07-19 bin/flash: smart dual-board deploy script (Uno R4 + ESP32-CAM) with animated spinner; auto-add autonomous prompt
2026-07-25 rename arduino-uno-r4 -> giga-r1; flash script -> cmds/flash.sh; add docs site
2026-07-25 blk: real language + touch-first editor, simulator, debugger
    - blk.js: expression/condition parser (maths, and/or/not, min/max/abs/
    round/random/clamp), variables, def/call procedures, repeat until/while,
    forever, if/else, break/continue, ask/find, led, analyze focus; linter,
    duration estimate, roundtrip serialize.
    - blkedit.js: blocks + text views, drag on pointer events (touch works),
    44px targets, selection action bar, drag-to-bin, undo, breakpoints.
    - blksim.js: offline rover sim with raycast ultrasonic so dist conditions
    mean something without the robot.
    - server: /api/blk-ask, /api/blk-find, /api/led; analyze takes a focus.
    - tests: extended test-blk.mjs, new test-blk-editor.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
2026-07-25 docs: V3 site redesign — hero video, telemetry ticker, roadmap rail, pricing
2026-07-25 site: roadmap from roadmap.json, map-style rail, drop V3 branding
    Roadmap cards render from docs/roadmap.json instead of hardcoded HTML —
    add/reorder versions or swap photos without touching the page. Rail now
    reads as a map (grid terrain, dashed route, numbered pins); cards expand
    on click/Enter to show a build photo. Placeholder image until real
    per-version stills are shot.
    Hero and title say "Blackout", not "Blackout V3" — the version lives in
    the roadmap now.
2026-07-25 dashboard: self-serve firmware update over USB
    Plugging a board in reveals an update bar under the topbar; it opens a
    modal that detects boards, runs cmds/flash.sh, and streams its output
    back over socket.io (flash-log / flash-done) with a Sage-face progress
    readout. Progress is derived from flash.sh's own ▸/✔ marks — arduino-cli
    percentages never reach the stream. Modal is locked while flashing and
    USB polling backs off so it can't poke the port arduino-cli is using.
    flash.sh now records what it put on each board in .last-flash (gitignored)
    so the dashboard can call firmware current/stale without the sketch
    reporting its own version, and can flash Blackout V2: the retired Uno R4
    sket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
2026-07-26 fpv: lower-latency feed, plain crosshair, firmware tuning
    - esp32-cam: CAMERA_GRAB_LATEST so fpv shows now, not a frame ago; force the
    full awb chain (whitebal + awb_gain + wb_mode) for the pink wash; framesize
    exposed over /control.
    - giga-r1: write-without-response on cmdChar + 7.5-15ms connection interval,
    so a drive burst doesn't wait out a 30ms window.
    - dashboard: fpv glass (heading tape, attitude line, reticle). reticle is a
    plain cross + pip, no ring.
    - test-fpv.mjs / test-layout.mjs: CDP smoke tests for fpv mode and for the
    "nothing scrolls" layout rule.
2026-07-26 blk editor: animate sheet close, swap the AI glyph
    Sheets and the scrim fade out through .is-closing, the same way the sage
    modal already did; reopening clears the class so the pending timeout no-ops.
    Sage/AI marks go from ✦ to ※ — the sparkle read as someone else's logo.
2026-07-26 agent: session report — readable document + .json export
    New Report button in the agent foot opens everything the session knows:
    mission, link, verdict, environment, findings, analysis, conversation, event
    log. buildReport() makes one object; the modal renders it and Export .json
    downloads the same object, so the document and the export can't disagree.
    The raw packet rides along in the json, so attitude/co/bumps and any csv field
    that has no tile yet still ends up in the export.
    test-report.mjs (npm run test:report) drives the real page over CDP and checks
    both the rendered sections and the downloaded json.
2026-07-27 offline-proof the dashboard + mirror mode for the judges' tablet
    venue wifi is not a dependency we get to have, so nothing loads off a cdn
    anymore: fonts, three/GLTFLoader, react/react-dom/htm and socket.io are all
    vendored under server/public/vendor (re-vendor with `node cmds/vendor.mjs`).
    drops the `glob` dep too — readdir on /dev does the same job.
    mirror mode: the dashboard opened over the lan is telemetry only until the
    host grants it from CONNECTED DEVICES. host = whoever loaded it over
    loopback, decided server-side from the socket address, so a granted client
    is enforced on the server as well. `stop` is never gated. grants are held
    by ip so a tablet that drops wifi for two seconds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
2026-07-28 sage chat history, fpv zoom steps, R2 turbo
    - blk editor: Sage conversations save themselves to localStorage (20 chats,
    40 messages each), with a list to reopen or delete them and ＋ for a fresh
    thread. Context window sent to the model goes 10 -> 20 messages, both ends.
    - fpv: OPTIONS (or the hud button) cycles FILL / FIT / 125% / 160%. FILL is
    the old crop-to-viewport behaviour and stays the default.
    - drive: hold R2 for 200 pwm instead of the fixed 110. Pad only.
    test-blk-editor.mjs covers save/reopen/delete of a chat.
2026-07-30 first-run tour, new brand mark, JetBrains Mono everywhere
    Walkthrough on first load: one spotlight box stepped through the brand,
    link, stage, camera, sensors, Sage, drive and console. Anchors that
    aren't on the page drop out of the walk, so mirror mode gets a shorter
    tour instead of a broken one. The app goes `inert` behind it and a
    capture-phase key listener eats the window-level shortcuts inert can't
    reach; the gamepad is polled, not evented, so it checks a flag. Runs
    once per browser, restartable from the console drawer. en + es.
    Typography is now JetBrains Mono for both display and mono — it ships
    as a variable font, so two subset files cover 400-800 and the ten
    per-weight copies Goo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
2026-07-30 landing: custom domain robotblackout.com
2026-07-30 landing: point links at jesodium/Blackout, drop CNAME until DNS is live
2026-07-30 landing: new finale copy, photos into marketing/
2026-07-31 fpv: sage glass card over the feed + analysis button in the hud
    Same panel as the marketing frame (docs/marketing/template.html #03-telemetry)
    so what people are shown and what they get are the same object. Stats run down
    the right instead of across — it carries every sensor, not the headline four.
    Rail agent (voice picker, verdict, history) stays in the cockpit; fpv keeps the
    readout, the hud keeps the buttons.
    Also: "intent.speaking" en/es, marketing frames gitignored.
2026-07-31 landing: shrink finale slogan and blur its glow
2026-07-31 landing: bigger, glossier nav links spread across the bar
2026-08-01 ble picker: landscape sheet with assumed model, landing title + nav tweaks
    - BLE picker reshaped like the OS chooser: scan bar under the header,
    assumed-model line per row, scan status parked next to Cancel
    - footer menu animates out instead of vanishing; reduced-motion covers the
    new scan animations
    - landing: new title, nav hidden under 680px, light mark + sim shot assets
2026-08-02 landing: video clips in the run/pricing cards, smaller es finale headline
2026-08-03 sage: svg eye rig replaces the ascii face
    every shape drawn once and cross-faded by mood, so state changes tween
    instead of swapping a glyph. eyes track the pointer via css vars.
    used by the agent panel, briefing, and the firmware flash progress.
    npm run test:face checks every mood has its css rule.
2026-08-03 docs: fpv/agent screenshots + kenney pad glyph set
    New landing assets: FPV stills (wide, near, sage overlay), agent box
    shot, and the Kenney input-prompt SVGs (keyboard + PlayStation) under
    docs/assets/pad/. Not wired into any page yet.
2026-08-03 landing: sponsors strip + sponsors.html with diamond/platinum/standard ranks
2026-08-03 docs: sync the site from nightly — sponsors section + sponsors.html, fpv/pad assets
2026-08-04 site: strip it back to the content, add the hover shove and the scramble swaps
    The landing page and the sponsors page lose the decoration: gsap and
    ScrollTrigger, the grain layer, the scan sweep, the HUD readouts, the
    telemetry ticker, the blurred manifesto, the language wipe, the hero photo
    plate behind pricing and every hover lift. index.html goes 963 -> ~610 lines
    and the only scroll motion left is one IntersectionObserver fade-up, gated on
    a .js class so no-JS still renders. Saved frames section is gone.
    What replaced it, on purpose:
    - the run: hovering a card drags its frame open from the bottom-left corner
    (scale 1.4, up into the gap so it never covers its own label) and every
    co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
2026-08-05 oled: drop the on-screen control menu, shrink status text, wire cam heartbeat
    Menu (root/sensors/display, contrast knob) is gone from the board and the
    dashboard's OLED drawer tab — status screen is icon-only for link state now,
    board name and cam line both smaller. Server pings the esp32-cam every 5s and
    pushes connected/not-connected onto the board over the same cmd channel.
2026-08-06 landing: live 3d rover viewer, console mockups, floating oval nav
    The app section gets real in-browser hardware: a three.js viewer on
    docs/models/rover.glb (scene.js, self-hosted three + GLTFLoader, no cdn)
    with the same isometric/front/top/side/free angles the dashboard has, plus
    static cam-*.jpg stills as the poster state.
    Also: fpv and sage console mockups, a blkedit clip in the app section, a
    full-res hero video with a poster frame, and the topbar becomes a fixed
    floating pill over the hero instead of an edge-to-edge sticky strip.
    shot-agent-box.jpg is replaced by the live mockups.
2026-08-06 docs: sync the site from nightly — 3d rover viewer, oval nav
    Brings docs/ up to nightly ee25fbe. Since the last sync main also missed
    the model-library roadmap and the stripped-back landing copy, so those
    land here too.
    - live three.js rover viewer (models/rover.glb, js/scene.js, vendor/)
    - fpv + sage console mockups, blkedit clip, full-res hero with poster
    - topbar is a fixed floating pill over the hero
    - drops the stale hardware checklist and shot-agent-box.jpg
2026-08-06 server: cdp helper + blk editor screen recorder for the landing page
2026-08-06 server: mission recorder + dashboard replay
    Records telemetry and cam stills to server/recordings/ while a run is in
    flight, then plays them back under the live FPV glass with a scrubber.
    Sage findings, blk decisions and analyses get marked on the timeline.
    Frame grabs run server-side (vision.js /capture) — the cam is a different
    origin, so a canvas drawn from the dashboard's mjpeg <img> is tainted.
    Start refuses when the cam is offline; recordings/ is gitignored.
    npm run test:rec covers stamps, run.json, listing and id traversal.
2026-08-06 landing: Mandarin translation
2026-08-06 giga: fix sonar reading 999, move oled + sonar pins
    echo was on bare INPUT. a floating input on the giga sits HIGH, so pulsein()
    never caught a rising edge, timed out, and every distance came back -1 — 999 on
    the dashboard, with correct wiring and a working sensor. INPUT_PULLDOWN fixes it.
    verified on the bench: 2.6cm - 194.8cm tracking a hand.
    also moved the oled to d22-d28 (whole panel on the double-row header, frees
    d11/d13/a0/a1) and the sonar to d32/d34.
2026-08-12 giga: bme280 replaces dht11, oled hud driven by the server
    dht11 is off the robot. bme280 in its place (temp/humidity/pressure) on the
    hardware i2c bus, d20/d21 — it can't go on d44/d46, neither pin has an i2c
    alternate function on the h747, so Wire can't be pointed at them. d2 is free now.
    oled shows a real hud instead of a status screen: splash blinks CONNECTED, then
    temp/humidity/distance with a safety level. the board draws it and decides
    nothing — the server computes the level from the same statuses() the agent
    reasons over and formats the metrics line, so the screen can't contradict what
    sage is saying. rides the existing "cmd" channel, rate-limited to 4hz because
    ble does one wri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
2026-08-13 giga: oled video from the dashboard, height from pressure
    pick a clip in the drive zone and it plays on the robot's own 64x128 panel, then
    the panel goes back to the hud by itself. the clip is uploaded into the giga's
    8mb sdram first and played from there off the board's own micros() clock, so a
    ble drop mid-clip can't stutter or strand it — and it reverts on end, on link
    loss, or after 4s with no chunk mid-upload.
    not streamed frame-by-frame: that capped at single-digit fps and it isn't a code
    problem. 60fps is ~61KB/s and a with-response write is round-trip bound at the
    ~15ms connection interval, so uploading pays the link cost once instead of every
    frame. VID_CHUNK stays under the boar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
2026-08-17 giga: matrix rain replaces oled video, bh1750, relative elevation
    - oled video dropped (ble can't carry frames); panel screensaver now
    animates on the board, link carries mtx,on/off only. test:matrix.
    - bh1750 lux parsed into the csv/packet, nothing displays it yet.
    - elevation is now relative to the first reading and leaks toward
    ambient (REF_TAU) so weather doesn't read as climbing; tile toggles
    m/cm. test:elev.
    - flash.sh: show arduino-cli output on failure, rosetta/port hints,
    one silent upload retry.
2026-08-19 giga: blk runs on the board, screensaver set
    compile() flattens a workflow into instructions the giga's blk vm plays
    itself, so `forward until dist < 15` checks in one loop() pass instead of
    a ~400ms ble round trip. say/log/led/analyze/ask/find still bounce up to
    the pc as evt events; anything the narrow instruction set can't hold
    falls back to the browser interpreter.
    matrix rain becomes one of four screensavers (scr,<n>): rain, bouncing
    blackout, starfield, self-playing tetris. sensors drop to 2hz while one
    is up and the rover is idle — a sonar ping inside a 20ms draw tick is
    what read as stutter.
2026-08-21 giga: motor pins by loom colour, enb off the shared timer; dash: judge view
    - enb moved d2 -> d10. d2/d3 are both TIM15 in the mbed core's PinMap_PWM and
    the second PwmOut on a shared timer never comes up, so ena claimed it and
    motor b sat dead or stuck. d10 is TIM1, its own timer.
    - in1..in4 renumbered to match the loom's wire colours (d2/d7/d6/d4) instead
    of connector order — they're no longer contiguous, so MOTOR_PINS replaces
    the `for (p = IN1; p <= IN4)` range here and in motor_test.
    - sonar to trig d50 / echo d52; it's an RCWL-1601, and every sensor is on the
    3v3 rail — the giga's pins are not 5v tolerant.
    - devices roster is three modes, not a grant toggle: mirror / judg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
2026-08-22 dash: drop smoke/gas/air-quality readouts
    no mq sensor on the rover — the tiles, trend graph, findings and sage's
    narration were all reading a padded zero. pressure tile takes the freed
    slot, humidity takes the trend graph, and the prompts no longer name a
    hazard the board can't sense.
2026-08-22 site: drop gas/air-quality from the dashboard mock
    matches the dashboard — no mq sensor on the rover, so the demo agent
    talks temperature and humidity instead. en/es/zh.
2026-08-24 bench: bh1750 + servo sweep sketches, fix dht11/sonar pins
    bh1750_test scans the bus and reads lux off raw Wire; servo_cal sweeps one
    pin so a horn's real end angles come off the bench, not a datasheet.
    dht11_test moves to the DHT11 lib the build actually uses; hcsr04_test pins
    match how the panel is wired.
2026-08-24 sage: gemini primary, cerebras fallback; document the pca9685 arm
    BRAINS/chat() in server.js keeps one openai-sdk client per keyed provider and
    tries them in order, so a rate-limited or dead primary costs one retry instead
    of the run. Cerebras went paid; gemini is free tier and sees images, which the
    cerebras fallback does not (a fallback analyse answers blind).
    Keys move with it: GEMINI_API_KEY/GEMINI_MODEL in .env.example, the electron
    settings sheet and both dictionaries; the SAGE cloud pill probes the gemini
    root. hasAI replaces the CEREBRAS_API_KEY checks so a keyless install still
    boots and the AI routes answer 503.
    CLAUDE.md picks up the PCA9685 arm notes: i2c so servos cost no pins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
2026-08-24 sage: stop gemini thinking, drop a brain that answers 402
    Two things made a reply take ~21s and arrive as a raw truncated {"text": "All
    systems…
    gemini 3.6 is a thinking model and the thinking counts against max_tokens: a
    default call burned ~350 hidden tokens before writing a word, then ran out of
    budget mid-json, so parseSage fell through to raw and the panel showed the
    object. reasoning_effort "minimal" turns it off — 1.2-2.9s and clean json over
    5 runs, total_tokens 109 against 432. Sage only verbalises statuses() the server
    already computed, so there was never anything to reason about. It's per-brain
    (tune) because cerebras 400s on that value.
    The bodyless 402 is cerebras, not gem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
2026-08-25 sage: groq first, no sdk retries, skip the retry pass on 429
    cloud pill probes whichever brain is actually first, not a hardcoded host.
2026-08-25 vision: fail throttle 6s -> 30s
    a dark cam is ~19s of dead air per grab (3 urls x 8s timeout); at 6s nearly
    every chat turn paid it again and read as a slow llm.
2026-08-25 pca_test: bench rig into the tree, ch15 gripper, and the day's hardware traps
    The sketch and its flask page were living in a gitignored scratchpad and had
    already been lost once — recovered from arduino's build cache and moved into
    OUTDATED/ so they survive.
    Arm changes:
    - gripper is ch15 (an sg90), not ch11
    - ch8 wrist is a 360, not an sg90. That mislabel is what made it spin forever:
    an angle sent to a 360 maps to full speed, and only continuous channels get
    the deadman.
    - controls are tap-to-nudge / hold-to-run, at full power either way. Pulse
    width is speed and torque at once, so a 35% "slow" arrow was also 35% force
    and the shoulder could not lift its own arm. Step size is bu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
2026-08-25 gy-302 onto its own bus (Wire2), lux end to end, hand control
    bh1750 moves off the bme's bus to Wire2 (sda2 d9 / scl2 d8) so a shorted
    light sensor can't take the barometer down with it. lux now lands
    everywhere instead of being recorded only: dashboard tile (zeroOk — dark
    is a real reading), blk sensor index 10 in both blk.mjs and blkRead(),
    sage's reading lines, and the fake-data generator.
    i2c_scan/: the drive-a-line-low check that finds a reversed vcc/gnd
    module, which pins sda and scl high and reads as everything but power.
    pca_test: SPAN_US 500 -> 700, the base had nothing left at 500.
    hand.py: webcam hand control via mediapipe, talking to servo.py over
    http so the two never fight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
2026-08-26 sage calls her own tools, fetch-based cam feed, auto headlamp
    sage: agentLoop() in server.js — a `tool` in her json runs and comes back
    for another pass (bounded by SAGE_MAX_STEPS, default 3). camera/sensors are
    tools, led/finding/snapshot stay one-shot. no frame attached to the chat turn
    any more; she asks for one. steps stream out as sage-step. new: 10s telemetry
    snapshot from dataHistory (backwards, nothing to wait for).
    agent tab is a terminal now: one row per move, the still under the tool row,
    transcript on chat.feed so it survives a reload.
    cam: /stream read with fetch + mjpegSplit instead of <img src>. the browser's
    multipart decoder wedges silently — no load, no error. frames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
2026-08-28 wip: bench rig arm moves, panel face travel, blk guard, chat prompt trims
2026-08-30 wip: coco-ssd boxes on the feed, relay pins, bme re-probe, uno-r4 buzzer sketches
    detect.mjs + vendored tfjs/coco-ssd (18MB of weights) — the venue has no
    internet and stock cocoSsd.load() fetches from storage.googleapis. Frame is
    un-rotated before inference (coco-ssd is not rotation invariant) and rotBox()
    maps the boxes back so the overlay's inherited css transform lands them.
    test:detect checks the mapping off-browser.
    firmware: three active-low relay channels (d26/d28/d30, level set before
    pinMode so nothing flashes at boot), ENB d10 -> d5, and the bme re-probes on
    the env cadence instead of staying dead until a reset. i2c_scan runs the
    pull-up check and a swapped-line sweep on the co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
2026-08-30 doc: relay pins d26/d28/d30, active low
2026-08-31 fix: bme280 on Wire1 (SDA1 d102 / SCL1 d101)
    bme.begin(0x76) probed the d20/d21 Wire bus, so pressure read 0.00
    forever and the 5s re-probe never recovered. Pass &Wire1 and call
    Wire1.begin().
    i2c_scan sweeps d102/d101 too (bit-bang both polarities + hw Wire1)
    and dumps chip-ID registers, so a hit is identified by reg 0xD0
    instead of by address.
2026-09-02 feat: oled on i2c wire2, arm on the giga, non-blocking sonar
    - panel moved off spi (d13/d11/d10/d12) to a 4-pin ssd1306 at 0x3c on Wire2
    (d9 sda2 / d8 scl2) via a custom u8g2 byte callback; 1MHz clock, 25ms draw
    tick, periodic re-init so a dark panel recovers on its own.
    - pca9685 arm ported off the bench rig into arm.h — Wire (d20/d21) alone, OE
    on d32, every call guarded on armOk. BLE `arm,<joint>,<speed>` is its one
    call site; dashboard Arm pad holds/repeats at 300ms against the 800ms deadman.
    - sonar: one ping per send, median over a ring buffer, EMA dropped. removes
    ~180ms of blocking per pass — that was the dropped frames and the command
    latency both.
    - pins: dht11 A6 -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
2026-09-03 feat: arm recorder, hold bias, and the lag fixes it needed
    armrec.py + cmds/arm-configurator.sh: a flask serial pipe to the Giga that
    records takes to server/arm_moves.json, which the dashboard's arm pad turns
    into one tap per move. USB or BLE, operator's pick — a take recorded over BLE
    has comp-day timing in its gaps.
    Lag: the dev server defaults to HTTP/1.0 and closed the socket after every
    response, so a 300ms jog repeat was a fresh TCP connection each time. HTTP/1.1
    plus one-request-in-flight (gen++ on a stop drops queued repeats, so a release
    can no longer land behind them), and 127.0.0.1 so Safari stops trying ::1.
    Sag: playback ended on bare `arm,` — armStopAll(), a true kill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
2026-09-03 fix: BLE.poll() starvation, service-uuid scan, serial drain
    Commands landing late or not at all was the board, not the host: ArduinoBLE's
    HCI thread drops received packets when the sketch thread stops calling
    BLE.poll(), and an oled frame (~23ms) or a pulseIn() timeout is longer than the
    connection interval. blePump() pumps from inside those blockers.
    armrec.py: match the service uuid instead of the GAP name (which was still
    ArduinoBLE's "Arduino" — the BLE mode never found a board that was advertising
    the whole time), and drain the board's serial output so its 10Hz CSV can't fill
    the tty buffer and stall loop() inside Serial.println() (60ms/cmd -> ~1ms).
    Bench page: hold+/- buttons repl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
2026-09-03 feat: arm takes as files, per-take flags, sage arm moves, cam rotate
    arm_moves.json split into server/arm_moves/<name>.json — filename is the
    name, folder is the collection. Each take carries sage_can_use/show_in_app,
    renameable in place, and clean() shifts the operator's reaction time off the
    head on save.
    Also: per-joint speed slider recorded into the take, sag bias (hold as a line
    through pose, not a constant), travel budget off from the dashboard, gamepad
    jog on the arm pad, Sage can replay named takes, ASK FIRST gate on her tools,
    and a ROTATE button driving all four copies of the cam mount angle.
2026-09-06 feat: tapes, board black box, demo data; drop arm travel budget
    - tapes: whole manual runs recorded off sendCmd() and replayed as one tap
    (server/tapes/<name>.json, arm-take shape, @sage/@say/@analyze/@log/@led
    PC-only steps). Sage can propose one; same flags/gate as arm takes.
    - black box: logRing + RCC->RSR on the board, dumped as E:log lines and
    asked for on every connect, so the reason for the last drop is on screen.
    - demo data: console toggle fills dead tiles with plausible numbers; dist
    never faked, nothing fake leaves the browser.
    - arm: travel budget gone (no limit column, ARM_TRAVEL_MS, armLimits or
    arml,); ARM_JOG_MS 800 -> 3000. Hold bias and RE-HOME stay.
    - tests: test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
2026-09-07 feat: second esp32-cam on the arm, self-sorting by eFuse mac
    Two cameras now: the forward eye and a small one on the gripper. The same
    sketch goes on both boards — each looks its own eFuse MAC up in CAM_CHIPS
    and takes its slot's mDNS name and static IP, so an upload goes to whichever
    board is plugged in and it knows which camera it is. An unclaimed chip still
    comes up on DHCP as blackout-cam-<id> so it can be reached to be claimed, and
    flash.sh claims it straight out of esptool's upload log.
    - flash.sh: de-dupe per PORT, not per sketch dir (only one cam ever got
    flashed), claim_cam writes the chip into the free slot and reflashes, and
    .last-flash is keyed dir@chip so one cam can't ma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
2026-09-07 fix: flash.sh claimed neither cam, then flashed one twice
    The MAC regex wanted a single space after "MAC:" and esptool pads that out to
    a column, so claim_cam() never found a mac and both boards were left on DHCP
    with no static ip — silently, because the case had no default arm. It says so
    now, and the two eFuse macs are recorded in CAM_CHIPS.
    The post-compile port refresh was for the Giga, which re-enumerates; the cams
    do not, and two of them share $dir, so `head -1` handed cam 2 cam 1's port and
    uploaded to the same board twice while reporting both as flashed. Only go
    looking for a fresh port when the one we hold has actually gone away.
    test-cam blanks CAM_CHIPS in its own copy of the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
2026-09-07 feat: gripper row is a latch, ported off the R4 bench rig
    The gripper is not a jog like the other five: it has two jaw stops and a job.
    OPEN is a one-shot burst that parks itself, and that burst IS the open limit —
    a 360 has no end stop to find, so nothing but a clock stops it opening, and
    holding the button longer does not open it further. It latches open too, so the
    button greys out (class + aria-disabled, never `disabled`, or shift-click
    naming would go with the pointer events) until CLOSE takes the joint back.
    CLOSE latches: full pace to the jaw stop, then it eases to CLAW_HOLD and
    re-sends that against the deadman until you press it again.
    The latch lives beside armLedger, outside <A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
2026-09-07 feat: room LED strip as the robot's status light
    A Steren SHOME-1282 on the LAN, not on the Giga — the three relay channels are
    the robot's own lights, this one is mains-powered scenery the PC reaches over
    wifi, so it never touches BLE. ledd.py holds the device open as a stdin line
    pipe (a one-shot led.py call reconnects and reads status back, ~250ms, no good
    for a 5fps pulse) and parks the strip off when stdin closes — process.on("exit")
    never fires on a SIGINT'd server, the pipe closing is unconditional.
    frame(state, now) is the whole behaviour and it is pure: colour says what,
    motion and depth say how urgent. Blue breathe waiting on the rover, blackout
    orange solid clear, dark red br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
2026-09-07 feat: sage borrows her still off the live feed instead of killing it
    The cam serves ONE /stream and a /capture alongside it starves the shared
    frame buffers -- stream_handler returns and that socket is the only stream.
    The old workaround tore the feed down first (cam-yield -> grab -> cam-resume),
    which blacked out both cams on every client and paid ~12s to reopen.
    setFrameSource() lets server.js ask a browser for its newest frame over a
    socket.io ack with .timeout(800) -- no correlation id, no pending map, binary
    bytes, no base64. camFrames[] lives outside <CamView/> like armLedger does,
    and a frame older than FRAME_LEND_MS is refused so a stalled feed answers
    nothing rather than a frozen p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
2026-09-08 feat: cam network is a table, and the feed walks the addresses
    - esp32-cam: CAM_NETWORK picks a row out of NETS[] instead of an ssid define.
    Each row carries its own subnet, because a static IP only means something on
    the network it was minted for — flashing HOME while CAM_GW still said
    172.20.10.1 handed the cam an address its router would never route. A row
    with ip {0,0,0,0} is DHCP + mDNS. Adds the MW45AF router row (192.168.1.x).
    - dashboard: CAM_HOSTS is one list per cam and the offline retry walks it
    (nextCamHost), the same shape overCam() in vision.js already had. A feed
    pinned to one address died on every network move while Sage, who walks the
    list, kept working — w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
2026-09-08 fix: the disconnects were two blocking delays, not BLE
    The board's own black box named both. `log,` over USB (dumpLog prints to Serial
    unconditionally, so reading it never depends on the link that is broken) came
    back as nothing but `loop stall 550ms` every 2s, 166 older events lost.
    - DHT11: the library delay()s 500ms inside every readTemperatureHumidity() to
    enforce the sensor's ~1Hz max rate (DHT11.cpp:48, `_delayMS = 500`). Plus the
    18ms start pulse and the ~30ms bit-bang, that is the 550ms. ENV_INTERVAL (2s)
    already paces the sensor, so the library's delay was pure blind spot --
    ~40-70 missed connection events at the 7.5-15ms interval, which drops inbound
    packets and reads ex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
2026-09-08 fix: delete the panel's 5s re-init; correct the dht read cost in CLAUDE.md
    The re-init's stated reason was "a glitch on a no-CS spi bus eating a command
    byte" -- the panel moved to i2c on 2026-09-02, and i2c is addressed and ACKed,
    so that failure mode left with the spi bus. What it still cost was ~310ms of
    u8g2's own blocking delays every 5s, which go through the gpio/delay callback
    rather than byte_cb, so blePump() in the transfer hook never ran inside them.
    The way back, if a panel ever comes up dark again, is initDisplay() +
    setPowerSave(0) + setContrast(255) ONCE on a trigger, never on a timer.
    CLAUDE.md called the dht11 read "30ms" in three places. It was 550ms, and that
    wrong number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
2026-09-10 fix: cam retries the wifi join in loop() instead of rebooting
    A failed join left the driver holding the state that failed, and
    ESP.restart() is a soft reset that inherits it — so the "reboot in 5s to
    retry" loop retried forever and only the RST button ever got the cam onto
    the hotspot. wifiJoin() cycles the radio off and wipes the NVS copy of the
    credentials first, and loop() re-tries it every 10s, so a hotspot that
    comes up after the cam does is joined with nobody touching the board.
    startServer() binds 0.0.0.0 and no longer waits on the link; mDNS is
    registered on the transition to up.
2026-09-10 feat: cerebras is the only brain, and nothing but sage touches the lamp
    Brains: openrouter, groq, gemini and lm studio are out — four spare
    providers meant four sets of keys to keep alive for a venue with no
    internet. BRAINS is still a list, so chat()'s retry pass is unchanged and a
    second brain is one line. Model is qwen-3.8-27b (gemma-4-31b 404s on every
    spelling, gpt-oss-120b refuses image_url and kills her vision), with
    reasoning_effort:"none" on qwen only or every reply arrives behind a
    paragraph of thinking. A dead brain now carries the reason it died — a
    model name the key can't reach used to report "AI key not set".
    Spanish: chat() folds every system message into one, because Ce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
2026-09-10 feat: a tape waits for every line it speaks, and the panes resize
    Tapes: a step's gap is measured from the END of the one before it, and a
    spoken step ends when the speech does — the gestures used to run ahead of
    the words, so the arm waved before "and the best part, I have an arm!" and
    an analysis landed a verse late. Gaps between two board commands are
    untouched, which is what the deadman lives on. tapePlay() returns a promise
    now; the panic key bumps armLedger.tapeTok so a step parked on a sentence
    still dies. New @ steps: @present (the judge greeting, a fresh grab against
    present.md) and @tape (one level deep, a self-naming tape is a note in the
    log). Every @say in a run is warmed into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
2026-09-10 feat: a gesture take can play under a spoken line, and ends with it
    PRESENT ARM: "@under ARM_DEMO_V2" plus an @sage cue about the six-DOF arm
    and its gripper, EN and ES. "sage tell us more about your arm" plays it —
    the about-the-arm trigger points here now, ABOUT THE ARM stays drawer-only.
    "@under <name>" is the one bit of concurrency in the player. Everything else
    is serial on purpose (a line runs long, the gestures must not run ahead), but
    that leaves a 26s take after an 8s sentence waving at a silent room. So the
    child starts and the run carries on, and underOff cuts it the moment the run's
    own steps are done — for a spoken step, when the TTS ends.
    Cues are spoken verbatim when the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
2026-09-13 feat: esp32-cam over usb serial, tui styles, docs figs; drop DEMO DATA
    the demo-data stand-in was never used on comp day, so the toggle, its
    ranges, strings and test:demo are gone.
2026-09-25 chore: add fluxus board config; ignore scratch cdp probes
2026-09-29 drop landing page; it lives on the website branch
2026-09-29 sage: cerebras stays the only brain, now on paid credit
    Cerebras ended its free tier 2026-08-17. Tried groq (free qwen caps at 8k
    tokens/min, a camera turn is ~11k), gemini flash-lite (2.8-9s) and mistral's
    ministral-8b (1.5-2.2s, invents readings); none came close, so Sage stays on
    cerebras qwen-3.8-27b on PayGo credit: 0.4-0.7s through /api/chat.
    - electron settings: cerebras key no longer labelled fallback, model
    placeholder is qwen-3.8-27b
    - PRESENT ARM asks before Sage plays it: it moves the arm
